OPEnSLab-OSU/OPEnSampler/README.md

# OPEnSampler
Code and materials for OPEnSampler: an Open-Source, inexpensive peristaltic pump-driven, air-tight, sampler device.
