OPEnSLab-OSU/OPEnSampler/2017 Q4/Code/FlowCharts/ReadMe

Flowchart "state machine" diagrams of code go here
