OPEnSLab-OSU/OPEnSampler/capstone/BOM/ReadMe

Place Ongoing Bill of Materials List and Links here
