OPEnSLab-OSU/OPEnSampler/2017 Q4/OPEnSampler Bag Bill of Materials v1.xlsx

Sheet: Electronics
Type | Value, Part # | Footprint Info | Quantity | PCB ID | Source | Cost/Unit | Cost
Capacitor | 100 uF | Electrolytic (2.54mm Pitch) | 2 | C1, C2 |  |  | 0
Capacitor | 10 nF | Ceramic (2.54mm pitch) | 2 | C3, C4 |  |  | 0
Capacitor | 10 uF | Electrolytic (2.54mm Pitch) | 2 | C5, C10 |  |  | 0
Capacitor | 0.1 uF | Ceramic (2.54mm pitch) | 5 | C6, C7, C8, C9, C11 |  |  | 0
Resistor | 1k | 0207/7 1/4 Watt | 1 | R1 |  |  | 0
Resistor | 10k | 0207/7 1/4 Watt | 1 | R2 |  |  | 0
Resistor | 30k | 0207/7 1/4 Watt | 1 | R3 |  |  | 0
Inductor | 2.2uH | 0309/10, 2.6A | 1 | L1 | Digikey (https://www.digikey.com/product-detail/en/abracon-llc/AIAP-01-2R2K-T/AIAP-01-2R2K-TCT-ND/3060625) | 0.38 | 0.38
Female Header | 1x8 | 2.54mm Squarepin | 1 | RTC |  |  | 0
Male JST Socket | 1x2 | 2.54mm Squarepin | 10 | ENABLE_INT, FLUSH, JP4, MO-JST, RTC_INT, Buttons 1-4, A-E | Digikey (https://www.digikey.com/product-detail/en/B2B-XH-A(LF)(SN)/455-2247-ND/1651045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) | 0.15 | 1.5
Male Header | 2x3 | 2.54mm Squarepin | 3 | 5V_BREAKOUT, I2C_BREAKOUT, RTC_INT_BREAKOUT |  |  | 0
Male Header | 1x3 | 2.54mm Squarepin | 1 | FLOW_METER |  |  | 0
Male Header | 1x9 | 2.54mm Squarepin | 1 | GSM |  |  | 0
Male Header | 1x6 | 2.54mm Squarepin | 1 | OLED |  |  | 0
Screw Terminal | 1x2 | 3.5mm Pitch, 1.2mm RoundPin | 2 | J1, MO_SCEW | Adafruit (https://www.adafruit.com/product/724) | 0.59 | 1.18
Rectangular Socket | 2x7 | 2.54mm pitch and spacing | 2 | VBB1, VBB2 | Digikey (https://www.digikey.com/product-detail/en/3m/N2514-6002-RB/MHC14K-ND/755177) | 1.89 | 3.78
IC Socket |  | DIL20 | 4 | IC1, IC2, IC3, IC4 | Digikey (https://www.digikey.com/product-detail/en/assmann-wsw-components/A-20-LC-TT/AE9998-ND/821752) | 0.29 | 1.16
 |  |  |  |  |  |  | 0
Shift Register | TPIC6B596 |  | 4 | IC1, IC2, IC3, IC4 | Digikey (https://www.digikey.com/product-detail/en/texas-instruments/TPIC6B596N/296-34573-5-ND/1670631) | 1.67 | 6.68
Arduino | Uno R3 |  | 1 | U1 | Arduino.cc |  | 0
GSM | FONA 808 2G |  | 1 | GSM | Adafruit (https://www.adafruit.com/product/2542) |  | 0
RTC | DS3231 |  | 1 | RTC | adafruit (https://www.adafruit.com/product/3013) | 13.95 | 13.95
OLED | SSD1306 |  | 1 | OLED | adafruit (https://www.adafruit.com/product/931) | 17.5 | 17.5
H Bridge | DRV8871 |  | 1 | U$1 | digikey (https://www.digikey.com/product-detail/en/texas-instruments/DRV8871DDAR/296-43024-1-ND/5722182) | 2.44 | 2.44
Flow Meter |  |  | 1 | FLOW_METER | adafruit (https://www.adafruit.com/product/828) | 9.95 | 9.95
Toggle Switch |  |  | 2 | JP4, ENABLE_INT | amazon (https://www.amazon.com/FBApayipa-Solder-Rocker-Switch-Toggle/dp/B01N2U8PK0) | 0.466 | 0.932
Interrupt Button |  |  | 1 | RTC_INT | Amazon (https://www.amazon.com/gp/product/B01IU898QA) | 0.699 | 0.699
Female Barrel Jack |  |  | 1 | Power Supply | Adafruit (https://www.adafruit.com/product/610) | 2.95 | 2.95
Female JST Housing | 1x2 (2.5mm) |  | 4 | ENABLE_INT, Power Supply, MO-JST, RTC_INT | Digikey (https://www.digikey.com/product-detail/en/jst-sales-america-inc/XHP-2/455-2266-ND/555485) | 0.1 | 0.4
JST XH Crimp Terminal | SxH-001T-P.6 |  | 8 | ENABLE_INT, Power Supply, MO-JST, RTC_INT | Digikey (https://www.digikey.com/product-detail/en/jst-sales-america-inc/SXH-001T-P0.6/455-1135-1-ND/527370) | 0.1 | 0.8
Rectangular Cable ASM. | M3DDA-1406J | 2.54mm pitch and spacing, Female, .5' | 2 | VBB1, VBB2 | Digikey (https://www.digikey.com/product-detail/en/3m/M3DDA-1406J/M3DDA-1406J-ND/230202) | 2.81 | 5.62
Battery | 2000 mAh |  | 1 | Power Supply | Amazon (https://www.amazon.com/Tenergy-2000mAh-Battery-Leads-Airplanes/dp/B00408X4LU) | 23.92 | 23.92
Stacking Headers |  | 2.54mm pitch, Squarepin Long Centered | 1 | Arduino Interfacing | Sparkfun (https://www.sparkfun.com/products/12693)
 |  |  |  |  |  |  | 93.841

Sheet: New Hydraulics
Item | Type and Dimensions | Source | QTY Per Order | Pieces Needed | Unit Price | Sampler Cost | Order | Description
PP Tube Fitting | 1/4'' OD x 1/8 MPT | usplastics (https://www.usplastic.com/catalog/item.aspx?itemid=29104&catid=603) | 1 | 24 | 0.63 | 15.12 | 24 | Bag Fittings
PP Tube Fitting | 1/4'' OD Tee | usplastics (https://www.usplastic.com/catalog/item.aspx?itemid=29008&catid=603) | 1 | 24 | 1.62 | 38.88 | 24 | Valve Tees
Spout Pack Bag | 250mL | IMPAK (http://www.impakcorporation.com/flexible_packaging/FTSSP250CSISL) | 500 | 24 | 0.33 | 7.92 | 1 | Sample Bags
Solenoid Valve | 2-POS Momentary NC | Shenzhen (https://pumpdyx.en.alibaba.com/product/1611593518-214713352/miniature_water_dispenser_solenoid_valve_DC6V_12V.html) | 100 | 26 | 1 | 26 | 1 | Valve
Peristaltic Pump | 202.330.012.050 | WMC Pumps (http://www.wmcpumps.com/index.php/series-200) | 1 | 1 | 60 | 60 | 1 | Pump
Push to Connect Bulkhead | 1/4''OD x 1/4'' OD x .67'' hole | usplastics (https://www.usplastic.com/catalog/item.aspx?itemid=42963&catid=833) | 1 | 2 | 3.34 | 6.68 | 2
Brass Straight Adapter | 1/2'' FNPT x 1/4'' tube OD | mcmaster (https://www.mcmaster.com/) | 1 | 2 | 7.97 | 15.94 | 2 | Flow Meter Adapter 1
PVDF Tubing | .17'' ID x .25'' OD | usplastics (https://www.usplastic.com/catalog/item.aspx?itemid=32842&catid=840) | 50 | 1 | 54.5 | 54.5 | 1 | Teflon Tubing
Mesh Filter | 480 micron, open ends | grainger (https://www.grainger.com/product/GRAINGER-APPROVED-3-3-4-Polypropylene-Filter-6UJJ7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) | 1 | 1 | 8.61 | 8.61 | 1 | Inlet Filter
O-Ring | 15mmID x 2mm CS | McMaster (https://www.mcmaster.com/) | 25 | 24 | 0.2452 | 5.8848 | 1 | Bag Cap Sealing
 |  |  |  |  |  | 239.5348

Sheet: Frame
Item | Type | Dimensions | Source | Quantity | Unit Cost | Cost | Comments
Machine Screw | M3 | 8mm | McMaster (https://www.mcmaster.com/) | 1 | 6 | 6
Machine Screw | M3 | 6mm x .5mm | McMaster (https://www.mcmaster.com/) | 1 | 6 | 6
Nut | M3 | M3 x .5mm | McMaster (https://www.mcmaster.com/) | 1 | 2 | 2
Machine Screw | M2 | 10mm x .4mm | Mcmaster (https://www.mcmaster.com/) | 1 | 6 | 6
Nut | M2 | M2 x .4mm | McMaster (https://www.mcmaster.com/) | 1 | 2 | 2
Aluminum Extrusion | HFS3-1515 | 610mm | Misumi (https://us.misumi-ec.com/vona2/detail/110300465870/?Inch=0&CategorySpec=00000042747%3A%3A15) | 5 | 3 | 15
Aluminum Extrusion | HFS3-1515 | 310mm | Misumi (https://us.misumi-ec.com/vona2/detail/110300465870/?Inch=0&CategorySpec=00000042747%3A%3A15) | 4 | 2.64 | 10.56
Aluminum Extrusion | HFS3-1515 | 200mm | Misumi (https://us.misumi-ec.com/vona2/detail/110300465870/?Inch=0&CategorySpec=00000042747%3A%3A15) | 6 | 2.64 | 15.84
Extrusion Bracket | HBLTBS3 |  | Misumi (https://us.misumi-ec.com/vona2/detail/110302755570/?Inch=0) | 32 | 0.75 | 24
T-Nut | HNSQ3-3 |  | Misumi (https://us.misumi-ec.com/vona2/detail/110300465710/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) | 1 | 8.28 | 8.28
Zipties | .1 in | .1'' x 4'' | Amazon (https://www.amazon.com/dp/B01018DB2E?ref=emc_b_5_t) |  | 4.99 |  | cable management and attaching valves
 |  |  |  |  |  | 95.68
