OPEnSLab-OSU/OPEnSampler/2017 Q4/Printed Components/Battery Case 9 - Case.stl

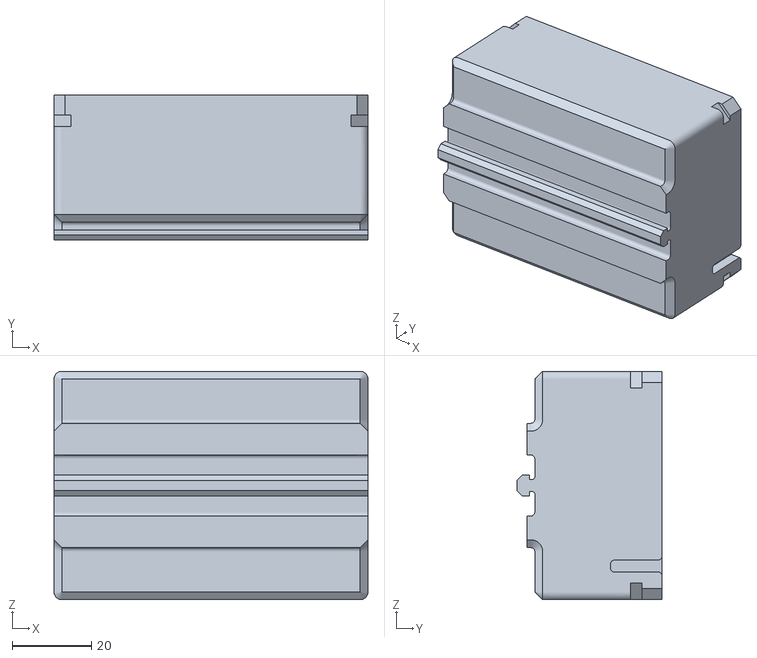
[picture p1: CAD file, 2017-11-14]
2017 Q4/Printed Components/Battery Case 9 - Case.stl
79.2 x 36.6 x 57.7
