OPEnSLab-OSU/OPEnSampler/capstone/15mm Extrusion Base/3D Printed Parts/STLs/Battery Holder Bottom July 13.stl

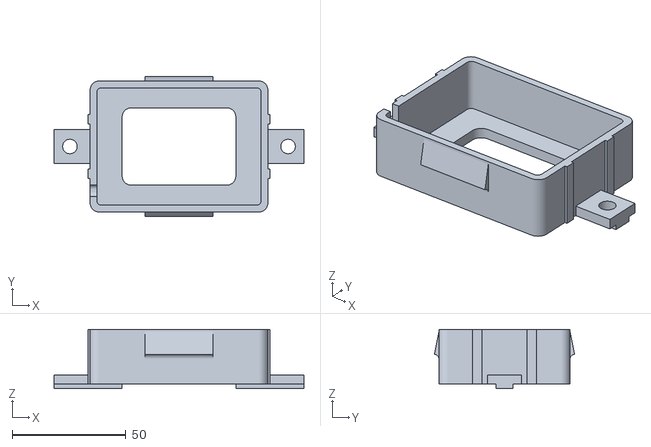
[picture p2: CAD file, 2017-07-13]
capstone/15mm Extrusion Base/3D Printed Parts/STLs/Battery Holder Bottom July 13.stl
110.0 x 61.7 x 26.0
