OPEnSLab-OSU/OPEnSampler/capstone/15mm Extrusion Base/Laser Cut Parts/DXF Files/Top Panel July 13.dxf

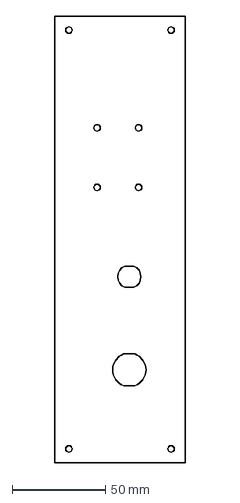
[picture p3: CAD file, 2017-07-13]
capstone/15mm Extrusion Base/Laser Cut Parts/DXF Files/Top Panel July 13.dxf
70.0 x 240.0 mm
