OPEnSLab-OSU/OPEnSampler/capstone/Water Sampler Prints/T_bracket_4040-3030.stl

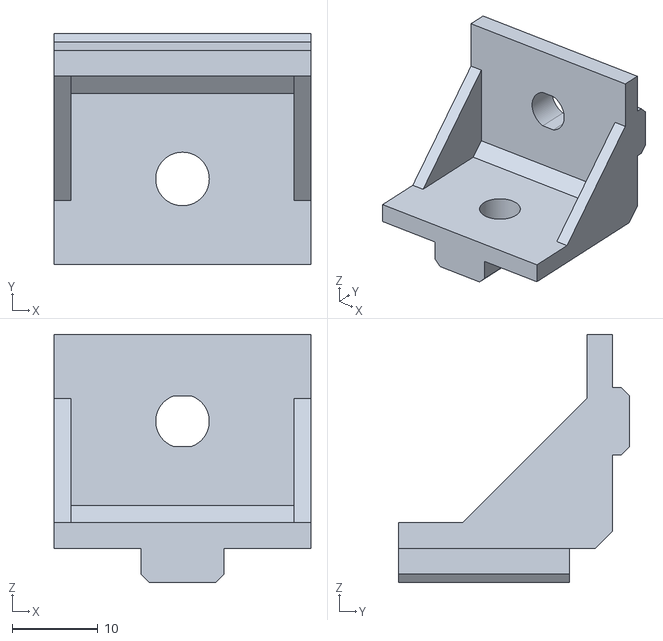
[picture p4: CAD file, 2017-11-07]
capstone/Water Sampler Prints/T_bracket_4040-3030.stl
30.0 x 27.0 x 29.0
