OPEnSLab-OSU/OPEnSampler/2017 Q4/Printed Components/VBB Case 9 - Cap.stl

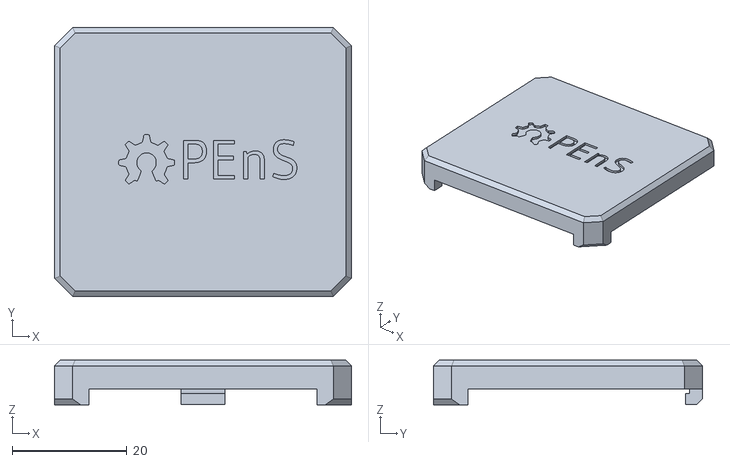
[picture p5: CAD file, 2017-11-14]
2017 Q4/Printed Components/VBB Case 9 - Cap.stl
51.8 x 47.0 x 7.80
