OPEnSLab-OSU/OPEnSampler/capstone/15mm Extrusion Base/3D Printed Parts/STLs/Valve Mount July 13.stl

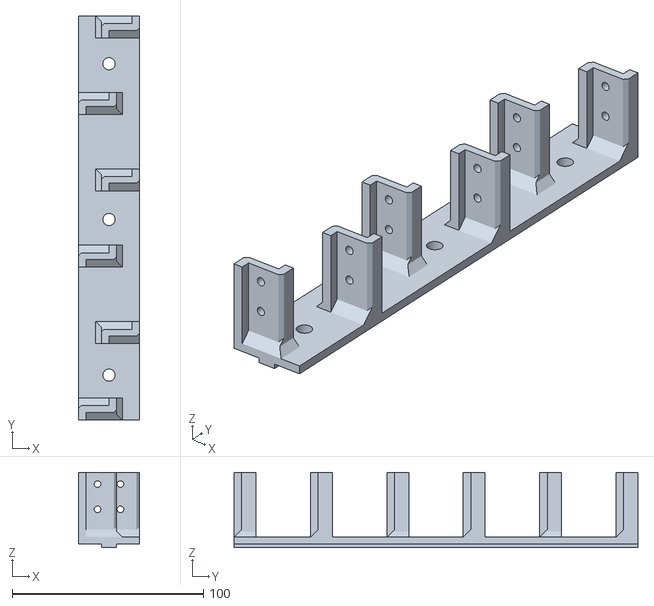
[picture p6: CAD file, 2017-07-13]
capstone/15mm Extrusion Base/3D Printed Parts/STLs/Valve Mount July 13.stl
32.0 x 211.5 x 39.5
