OPEnSLab-OSU/OPEnSampler/capstone/Water Sampler Prints/board_mount.stl

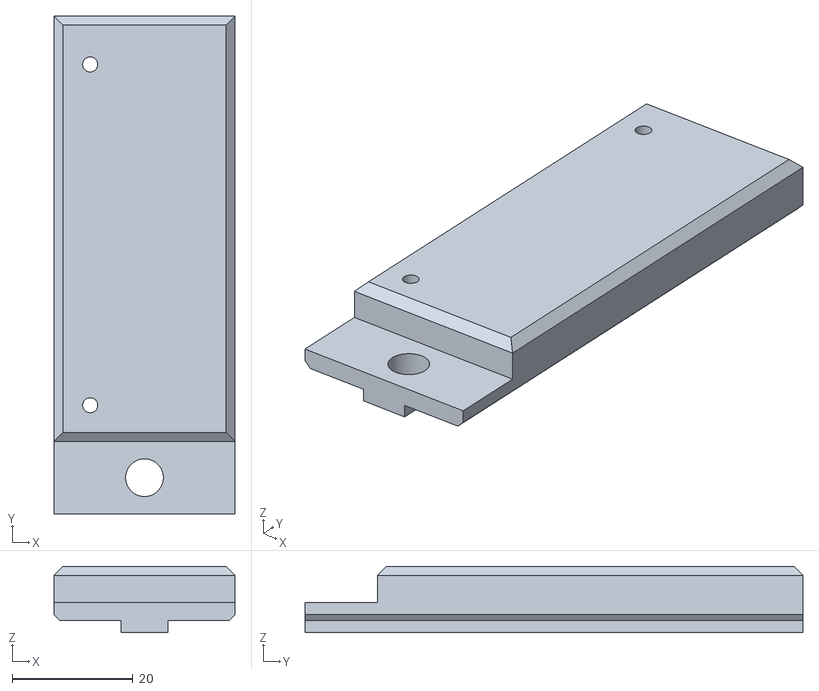
[picture p7: CAD file, 2017-11-07]
capstone/Water Sampler Prints/board_mount.stl
30.0 x 82.5 x 11.0
