OPEnSLab-OSU/OPEnSampler/2017 Q4/Printed Components/MCB Case 14 - Cap.stl

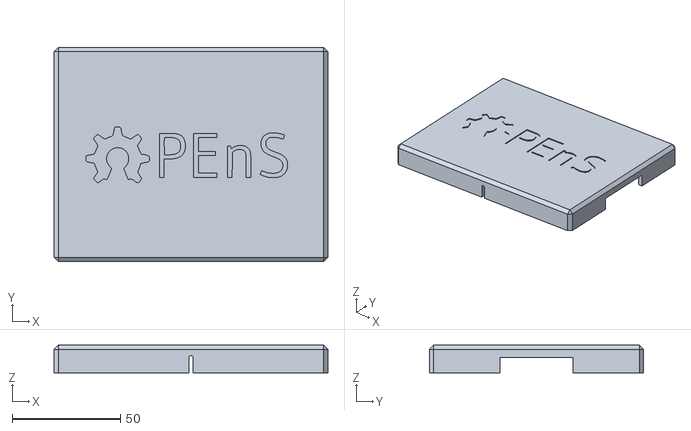
[picture p8: CAD file, 2017-11-14]
2017 Q4/Printed Components/MCB Case 14 - Cap.stl
126.8 x 99.2 x 12.9
