OPEnSLab-OSU/OPEnSampler/capstone/15mm Extrusion Base/3D Printed Parts/STLs/Bag Cap Inner July 13.stl

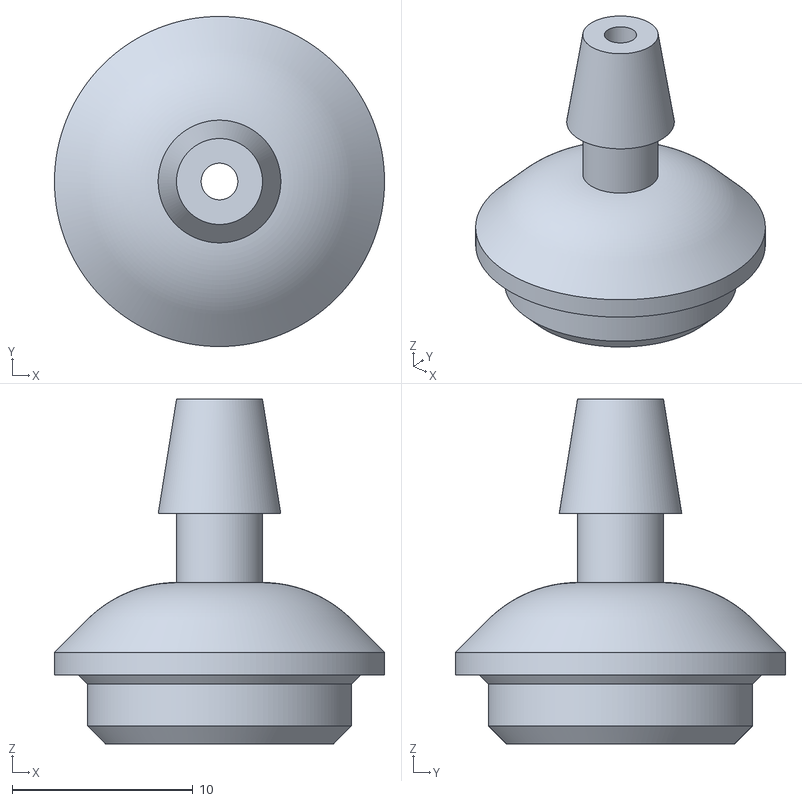
[picture p9: CAD file, 2017-07-13]
capstone/15mm Extrusion Base/3D Printed Parts/STLs/Bag Cap Inner July 13.stl
18.3 x 18.3 x 19.1
