OPEnSLab-OSU/OPEnSampler/capstone/Water Sampler Prints/arduino_mount.stl

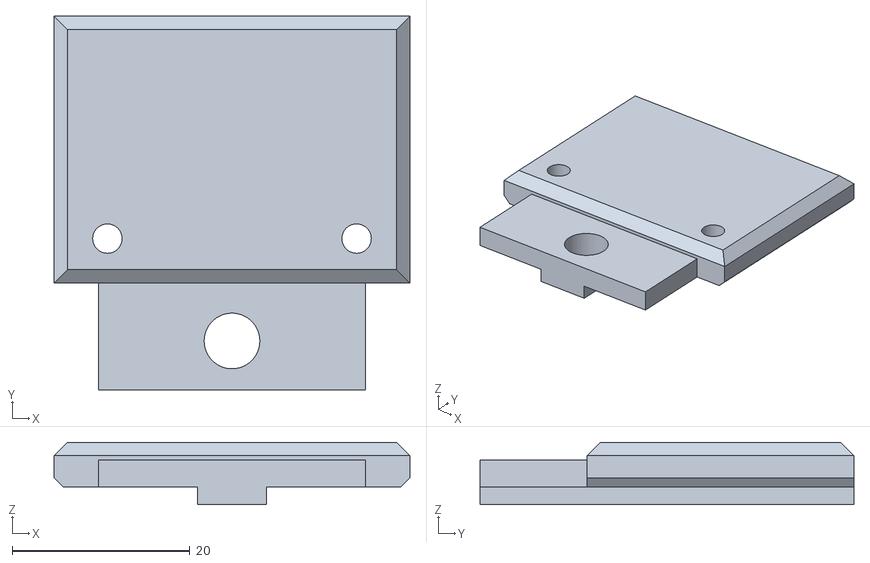
[picture p10: CAD file, 2017-11-07]
capstone/Water Sampler Prints/arduino_mount.stl
40.0 x 42.0 x 7.00
