OPEnSLab-OSU/OPEnSampler/2017 Q4/Printed Components/MCB Case 14 - Case.stl

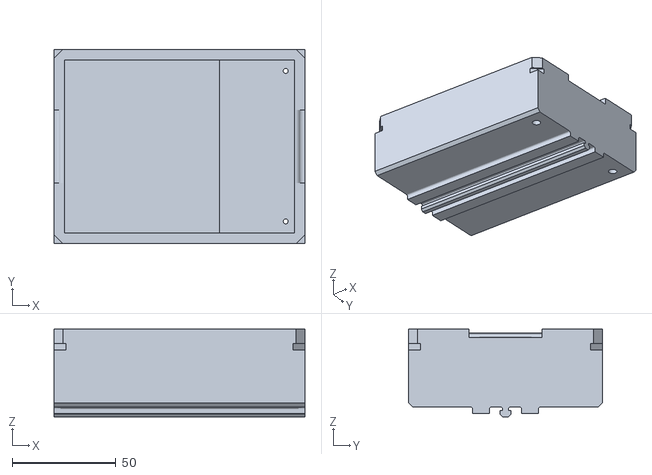
[picture p11: CAD file, 2017-11-14]
2017 Q4/Printed Components/MCB Case 14 - Case.stl
120.8 x 93.2 x 42.3
