OPEnSLab-OSU/OPEnSampler/capstone/15mm Extrusion Base/3D Printed Parts/STLs/Pump Mount July 13.stl

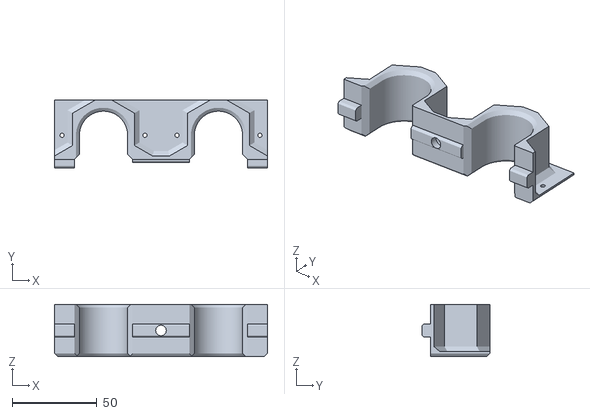
[picture p12: CAD file, 2017-07-13]
capstone/15mm Extrusion Base/3D Printed Parts/STLs/Pump Mount July 13.stl
126.0 x 40.0 x 31.0
