OPEnSLab-OSU/OPEnSampler/capstone/Water Sampler Prints/tnut_3030_v2.stl

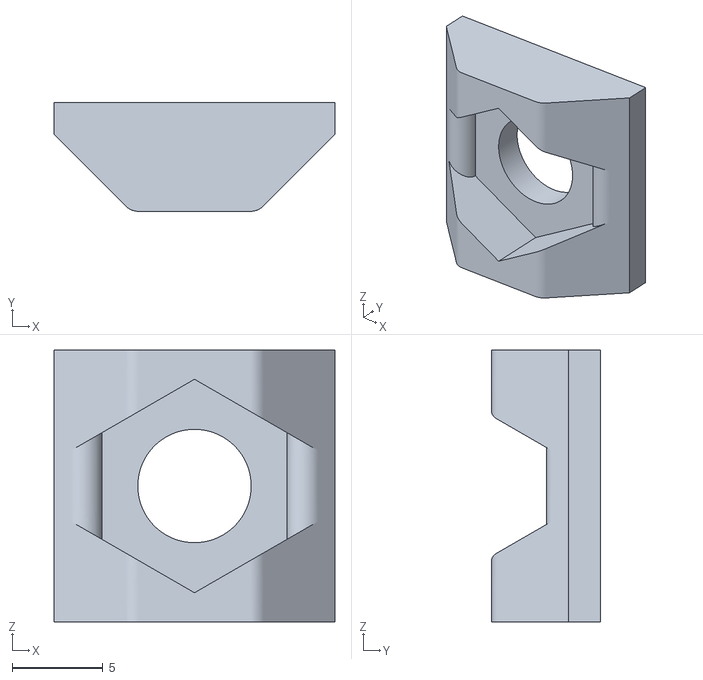
[picture p13: CAD file, 2017-11-07]
capstone/Water Sampler Prints/tnut_3030_v2.stl
15.5 x 6.00 x 15.0
