OPEnSLab-OSU/OPEnSampler/2017 Q4/Printed Components/VBB Case 9 - Case.stl

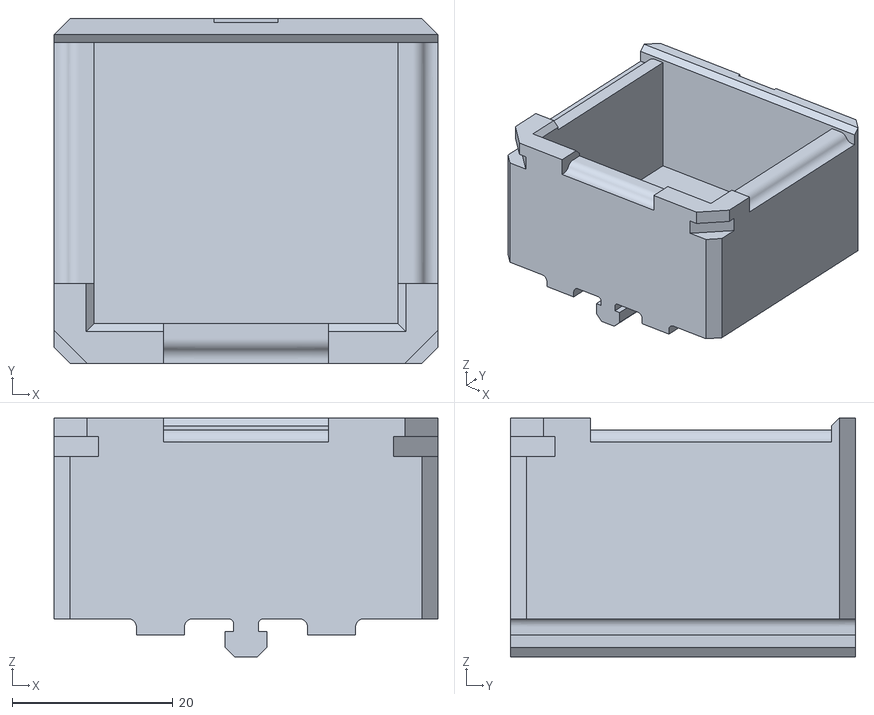
[picture p14: CAD file, 2017-11-14]
2017 Q4/Printed Components/VBB Case 9 - Case.stl
47.8 x 43.0 x 29.8
