OPEnSLab-OSU/OPEnSampler/capstone/15mm Extrusion Base/3D Printed Parts/STLs/spine spacer july 13.stl

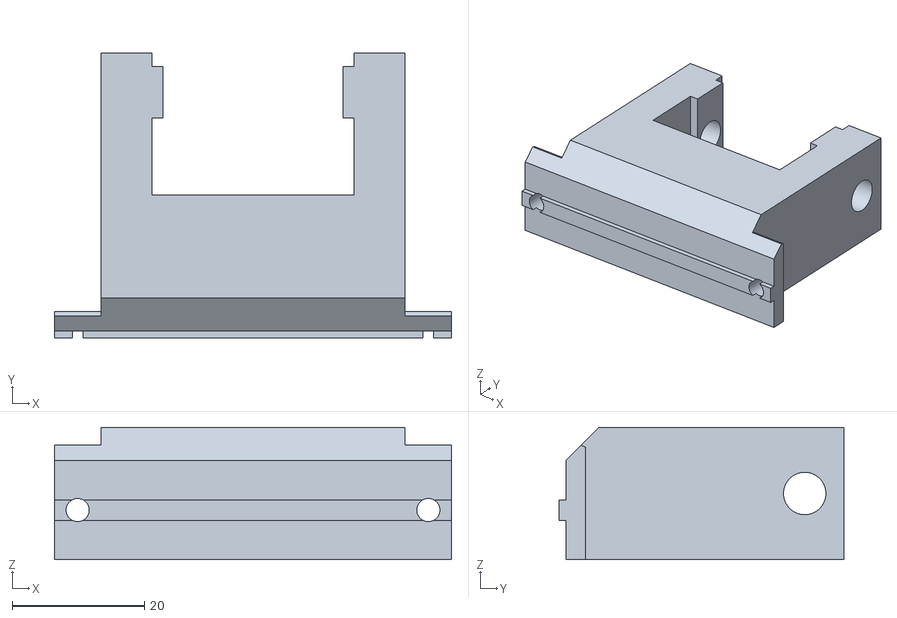
[picture p15: CAD file, 2017-07-13]
capstone/15mm Extrusion Base/3D Printed Parts/STLs/spine spacer july 13.stl
60.0 x 43.0 x 20.0
