OPEnSLab-OSU/OPEnSampler/capstone/Water Sampler Prints/valve_mount_U3030 v9.stl

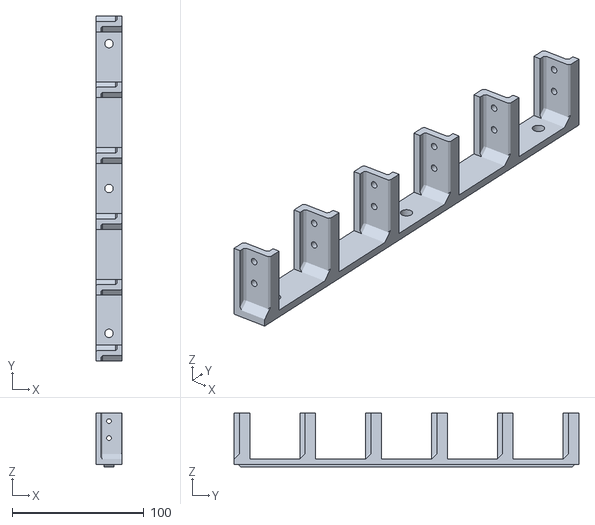
[picture p16: CAD file, 2017-11-07]
capstone/Water Sampler Prints/valve_mount_U3030 v9.stl
20.0 x 262.0 x 41.0
