OPEnSLab-OSU/OPEnSampler/2017 Q4/Printed Components/Battery Case 9 - Cap.stl

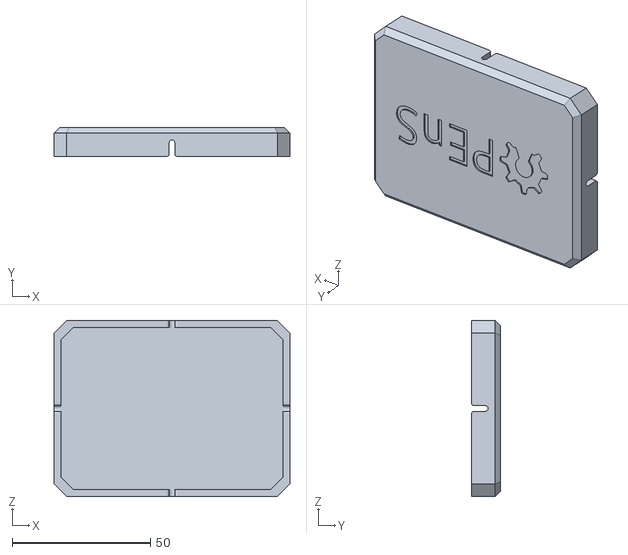
[picture p17: CAD file, 2017-11-14]
2017 Q4/Printed Components/Battery Case 9 - Cap.stl
85.2 x 10.5 x 63.7
