OPEnSLab-OSU/OPEnSampler/capstone/15mm Extrusion Base/3D Printed Parts/STLs/Bag Cap Outer July 13.stl

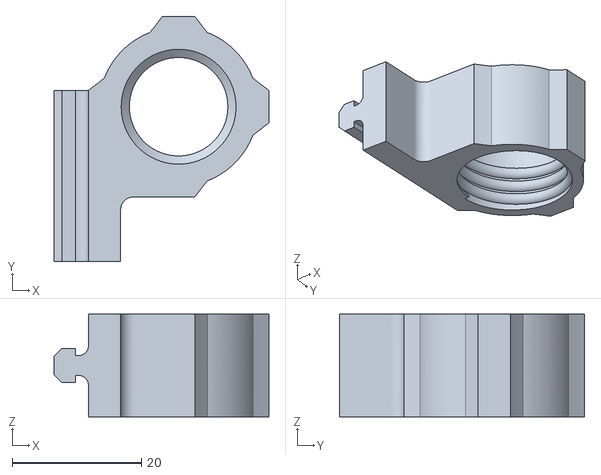
[picture p18: CAD file, 2017-07-13]
capstone/15mm Extrusion Base/3D Printed Parts/STLs/Bag Cap Outer July 13.stl
33.2 x 37.9 x 15.9
