OPEnSLab-OSU/OPEnSampler/2017 Q4/Printed Components/Bag Cap 10.stl

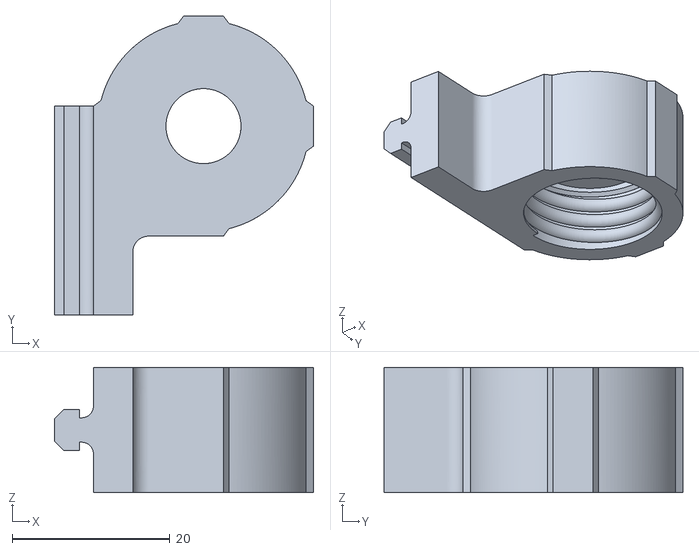
[picture p19: CAD file, 2017-11-14]
2017 Q4/Printed Components/Bag Cap 10.stl
32.9 x 37.9 x 15.9
