OPEnSLab-OSU/OPEnSampler/capstone/15mm Extrusion Base/3D Printed Parts/STLs/Battery Holder Top July 13.stl

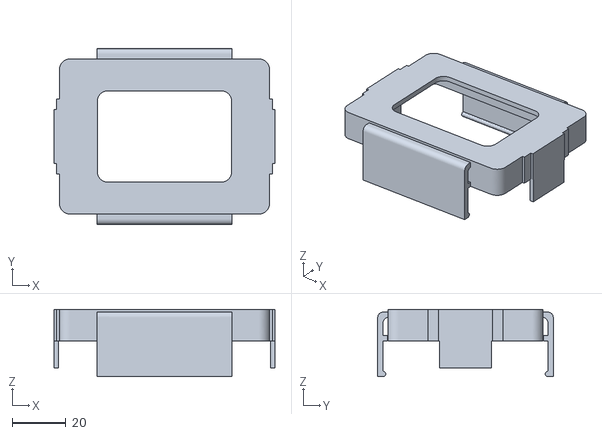
[picture p20: CAD file, 2017-07-13]
capstone/15mm Extrusion Base/3D Printed Parts/STLs/Battery Holder Top July 13.stl
82.2 x 65.3 x 25.0
