OPEnSLab-OSU/OPEnSampler/2017 Q4/Printed Components/Flow Meter Mount 7.stl

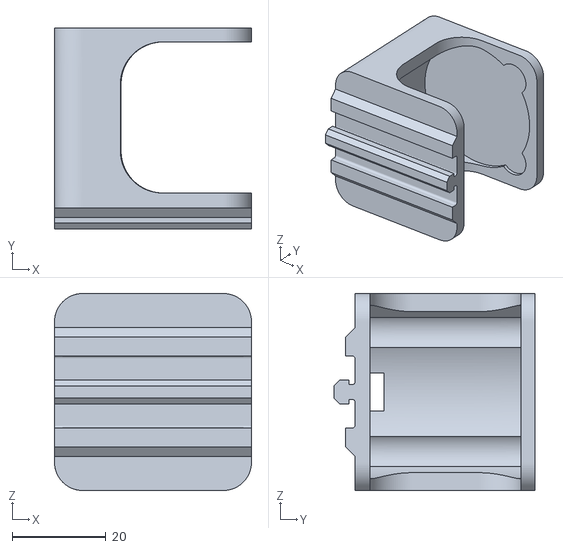
[picture p21: CAD file, 2017-11-14]
2017 Q4/Printed Components/Flow Meter Mount 7.stl
42.0 x 42.9 x 42.0
