OPEnSLab-OSU/OPEnSampler/2017 Q4/Printed Components/Valve Slider 1.stl

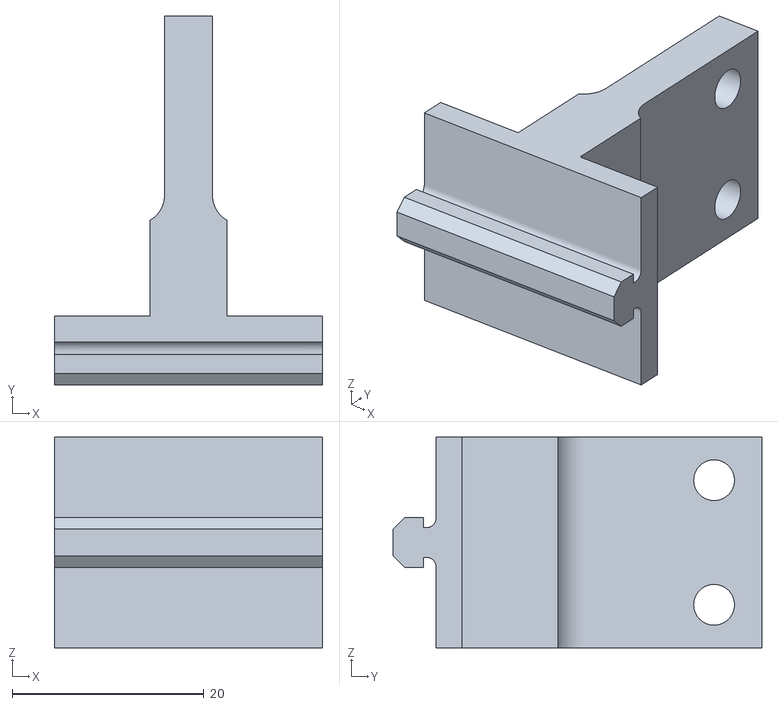
[picture p22: CAD file, 2017-11-14]
2017 Q4/Printed Components/Valve Slider 1.stl
28.0 x 38.5 x 22.0
