OPEnSLab-OSU/OPEnSampler/(list of files, cad)

Other CAD files:
capstone/15mm Extrusion Base/3D Printed Parts/Fusion360 Part Files/Bag Cap July 13.f3d
capstone/15mm Extrusion Base/3D Printed Parts/Fusion360 Part Files/Battery Holder July 13.f3d
capstone/15mm Extrusion Base/3D Printed Parts/Fusion360 Part Files/Pump Mount July 13.f3d
capstone/15mm Extrusion Base/3D Printed Parts/Fusion360 Part Files/Spine Spacer July 13.f3d
capstone/15mm Extrusion Base/3D Printed Parts/Fusion360 Part Files/Valve Mount July 13.f3d
capstone/15mm Extrusion Base/3D Printed Parts/Fusion360 Part Files/vSlot Bolt Head 30mm M6 July 13.f3d
capstone/15mm Extrusion Base/Laser Cut Parts/Part Files/Top Panel July 13.f3d
