OPEnSLab-OSU/OPEnSampler/2017 Q4/CAD/Assembly Link.txt

The assembly can be viewed and downloaded at the following link:

http://a360.co/2iAnQlj
