OPEnSLab-OSU/OPEnSampler/(threads)

Thread 11 (2020-06-24):

Battery voltage reduce over time

nguyenb5, 2020-06-24:
The current system doesn't have flow-meter so the whole system is time based. When the battery voltage change, the flow-rate change and give us more than 10% variable.

If cap the system at 12V using buck converter, we can have consistent flow-rate.
