OPEnSLab-OSU/OPEnSampler/capstone/BOM/WS4040 v1 Bill of Materials.pdf

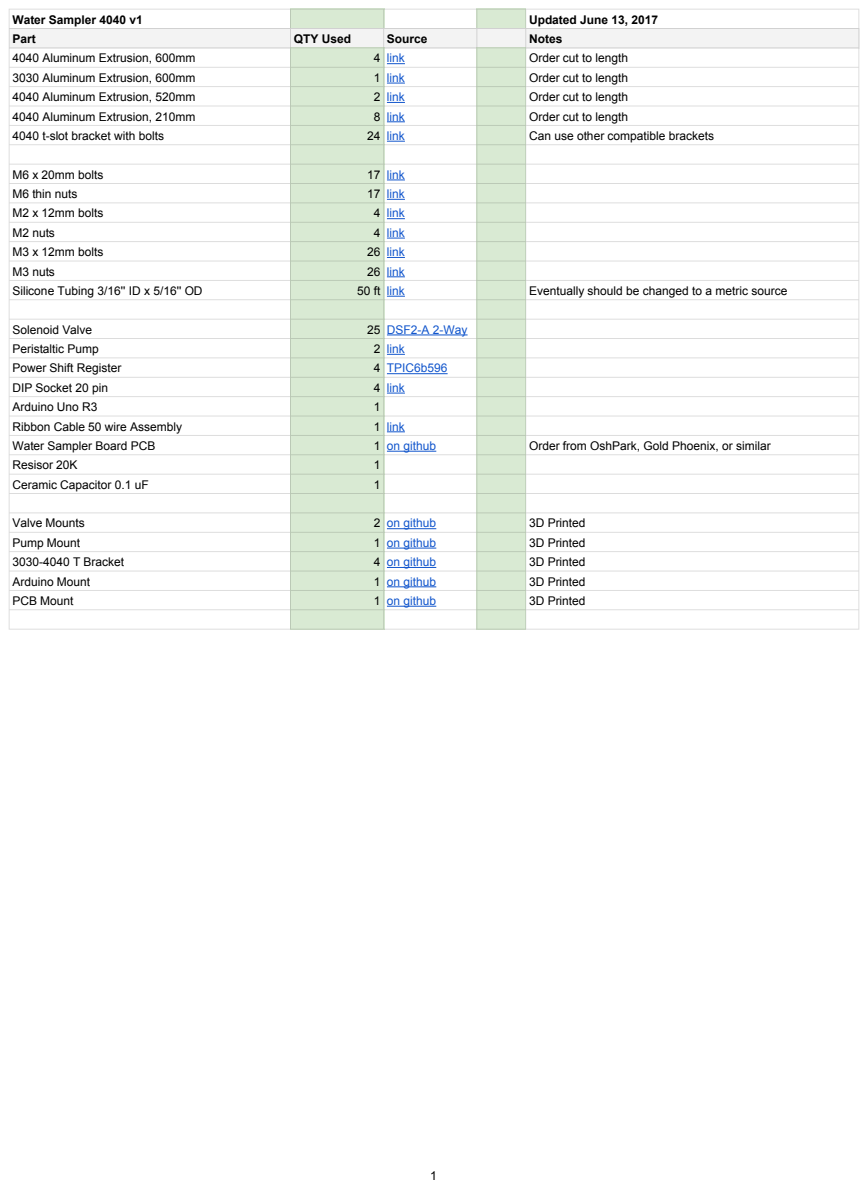
[picture p37: page 1]
Water Sampler 4040 v1; Updated June 13, 2017; Part; QTY Used; Source; Notes; 4040 Aluminum Extrusion, 600mm; link; Order cut to length; 3030 Aluminum Extrusion, 600mm; 4040 Aluminum Extrusion, 520mm; 4040 Aluminum Extrusion, 210mm; 4040 t-slot bracket with bolts; Can use other compatible brackets; M6 x 20mm bolts; M6 thin nuts; M2 x 12mm bolts; M2 nuts; M3 x 12mm bolts; M3 nuts; Silicone Tubing 3/16'' ID x 5/16'' OD; Eventually should be changed to a metric source; Solenoid Valve; DSF2-A 2-Way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
