OPEnSLab-OSU/OPEnSampler/2017 Q4/Code/FlowCharts/WaterSamplerSetup.pdf

# Setup

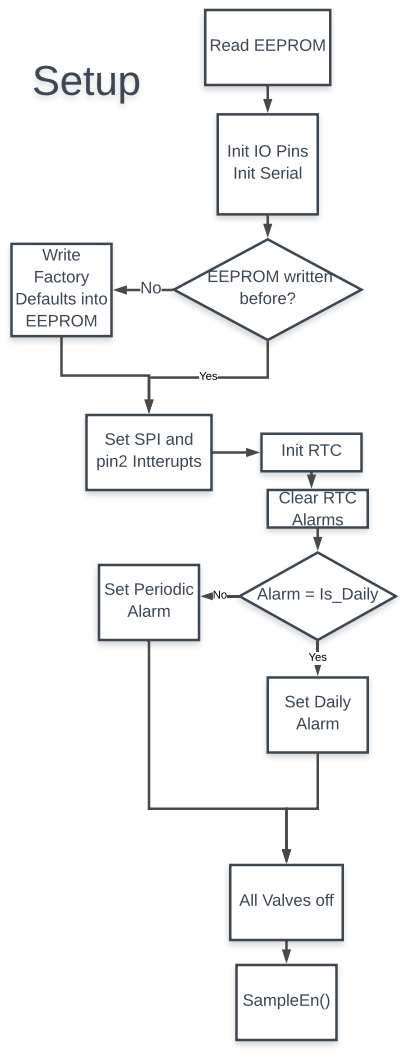
[picture p38: page 1]
Read EEPROM; EEPROM written before?; Write Factory Defaults into EEPROM; Alarm = Is_Daily; SampleEn(); Yes; Init RTC; Clear RTC Alarms; Set Daily Alarm; Set Periodic Alarm

Init IO Pins
Init Serial

Set SPI and
pin2 Intterupts

All Valves off

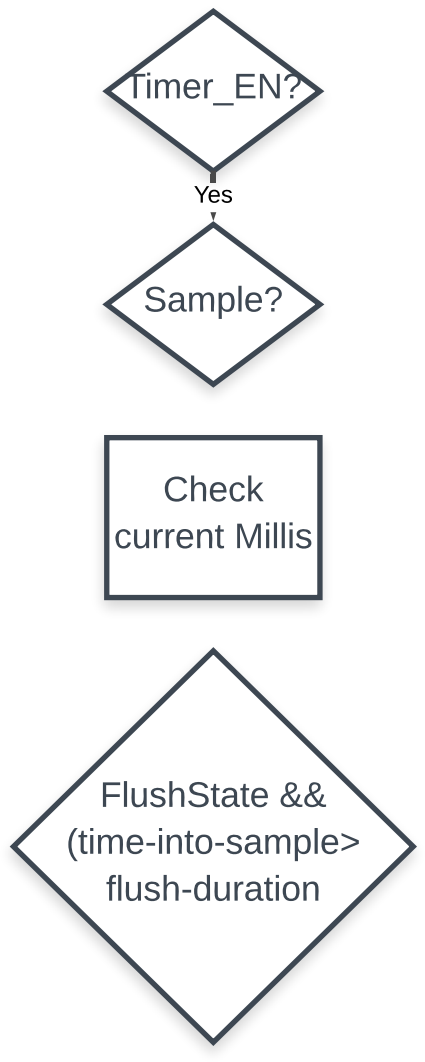
[picture p39: page 2]
Timer_EN?; Sample?; Yes; Check current Millis

FlushState &&
(time-into-sample>
flush-duration
