OPEnSLab-OSU/OPEnSampler/capstone/15mm Extrusion Base/Documents/Bill of Materials.pdf

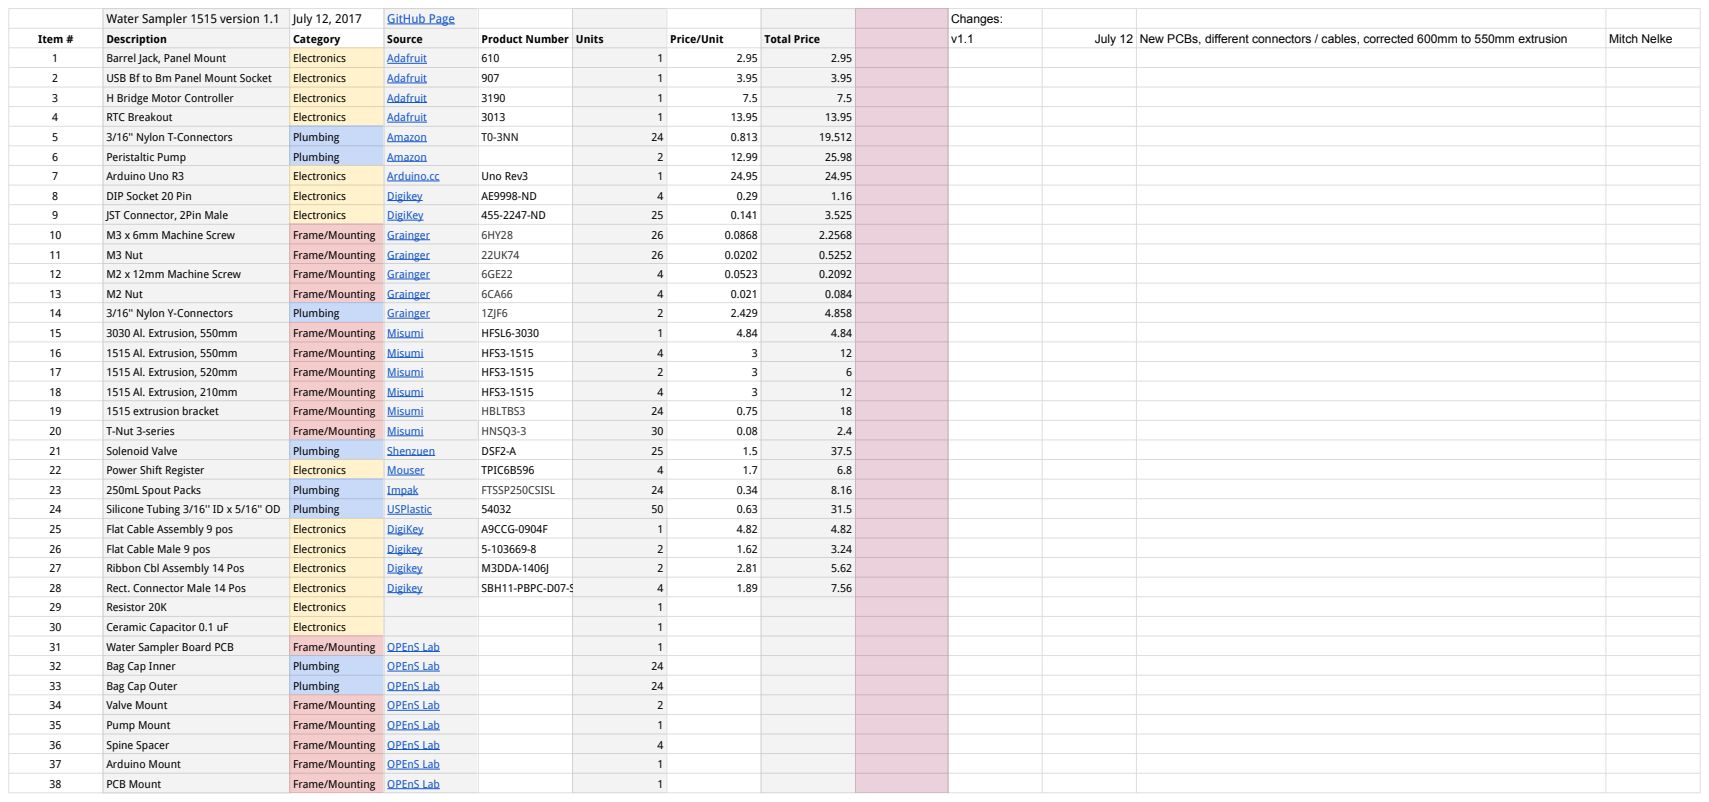
[picture p40: page 1]
Water Sampler 1515 version 1.1; July 12, 2017; GitHub Page; Changes:; Item #; Description; Category; Source; Product Number; Units; Price/Unit; Total Price; July 12 New PCBs, different connectors / cables, corrected 600mm to 550mm extrusion; Mitch Nelke; Barrel Jack, Panel Mount; Electronics; Adafruit; USB Bf to Bm Panel Mount Socket; H Bridge Motor Controller; RTC Breakout; 3/16'' Nylon T-Connectors; Plumbing; Amazon; Peristaltic Pump; Arduino Uno R3; Arduino.cc; Uno Rev3; DIP Socket 20 Pin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
