OPEnSLab-OSU/OPEnSampler/capstone/15mm Extrusion Base/3D Printed Parts/Drawings/1515 Assembly July 13.pdf

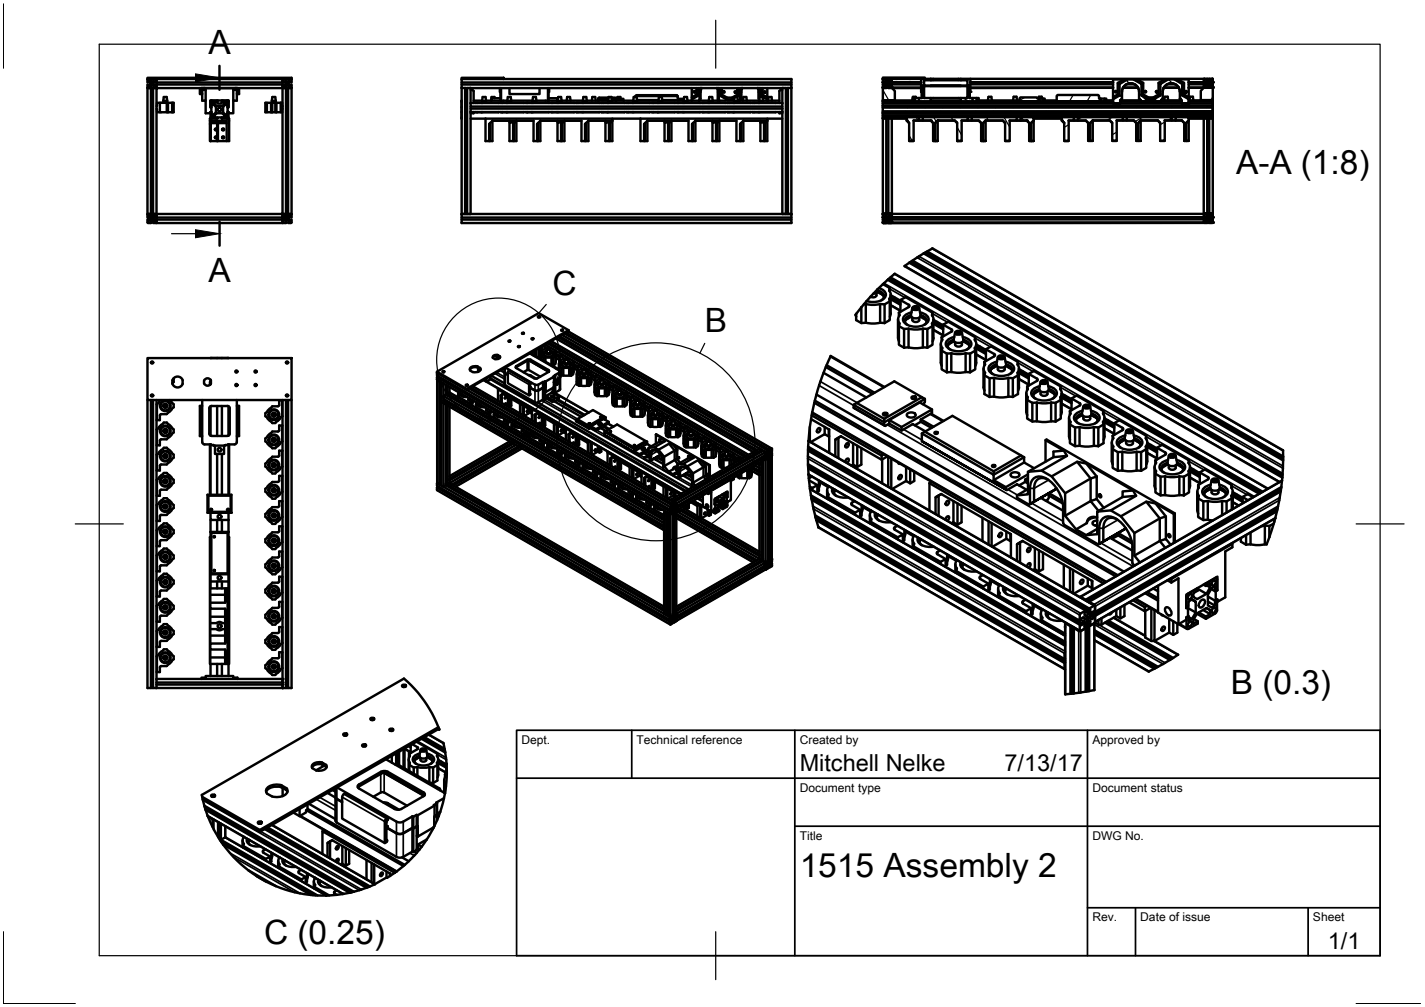
[picture p41: page 1]
Dept.; Technical reference; Created by; Approved by; Document type; Document status; Title; DWG No.; Rev.; Date of issue; Sheet; 1515 Assembly 2; Mitchell Nelke
