OPEnSLab-OSU/OPEnSampler/2017 Q4/Code/FlowCharts/OPEnSamlperLoop.pdf

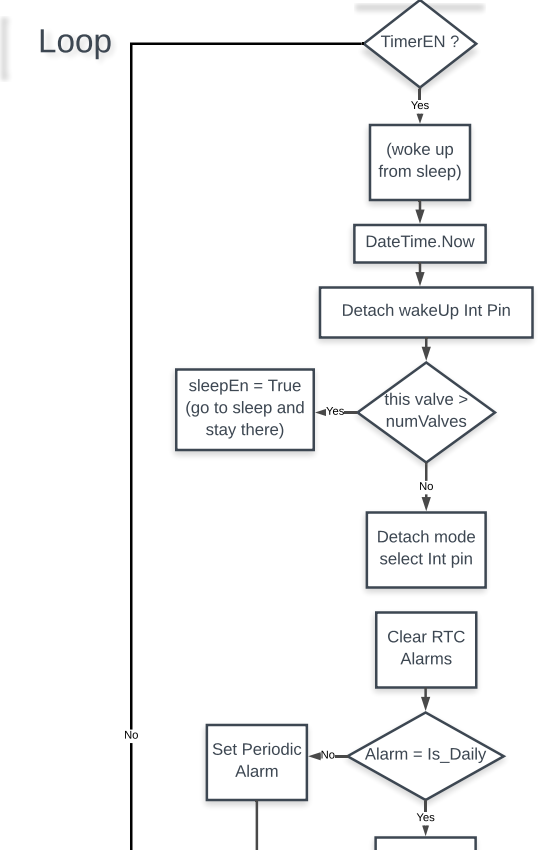
[picture p42: page 1]
(woke up from sleep); Loop; TimerEN ?; DateTime.Now; this valve > numValves; Yes; Clear RTC Alarms; Alarm = Is_Daily; Set Periodic Alarm

Detach wakeUp Int Pin

sleepEn = True
(go to sleep and
stay there)

Detach mode
select Int pin

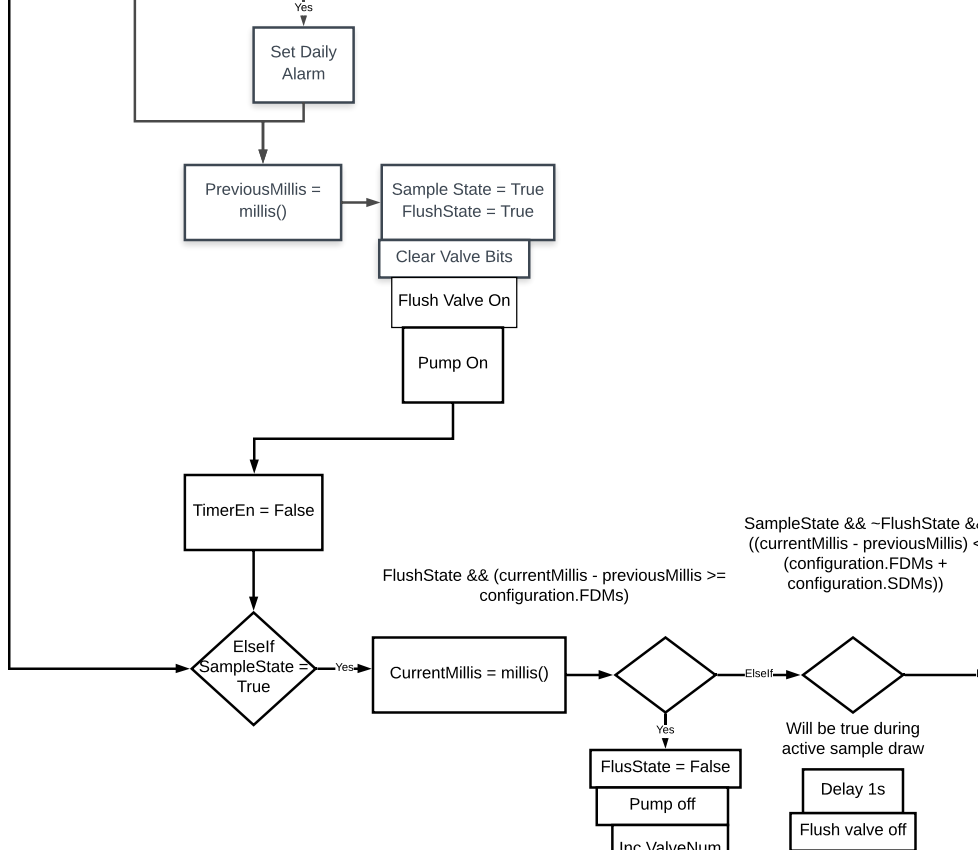
[picture p43: page 3]
Set Daily Alarm; Yes; PreviousMillis = millis(); Pump On; TimerEn = False; ElseIf SampleState = True; CurrentMillis = millis(); configuration.FDMs); FlusState = False; Pump off; Inc ValveNum; ElseIf; SampleState && ~FlushState && ((currentMillis - previousMillis) < (configuration.FDMs + configuration.SDMs)); Delay 1s

Sample State = True
FlushState = True

Clear Valve Bits

Flush Valve On

FlushState && (currentMillis - previousMillis >=

Will be true during
active sample draw

Flush valve off

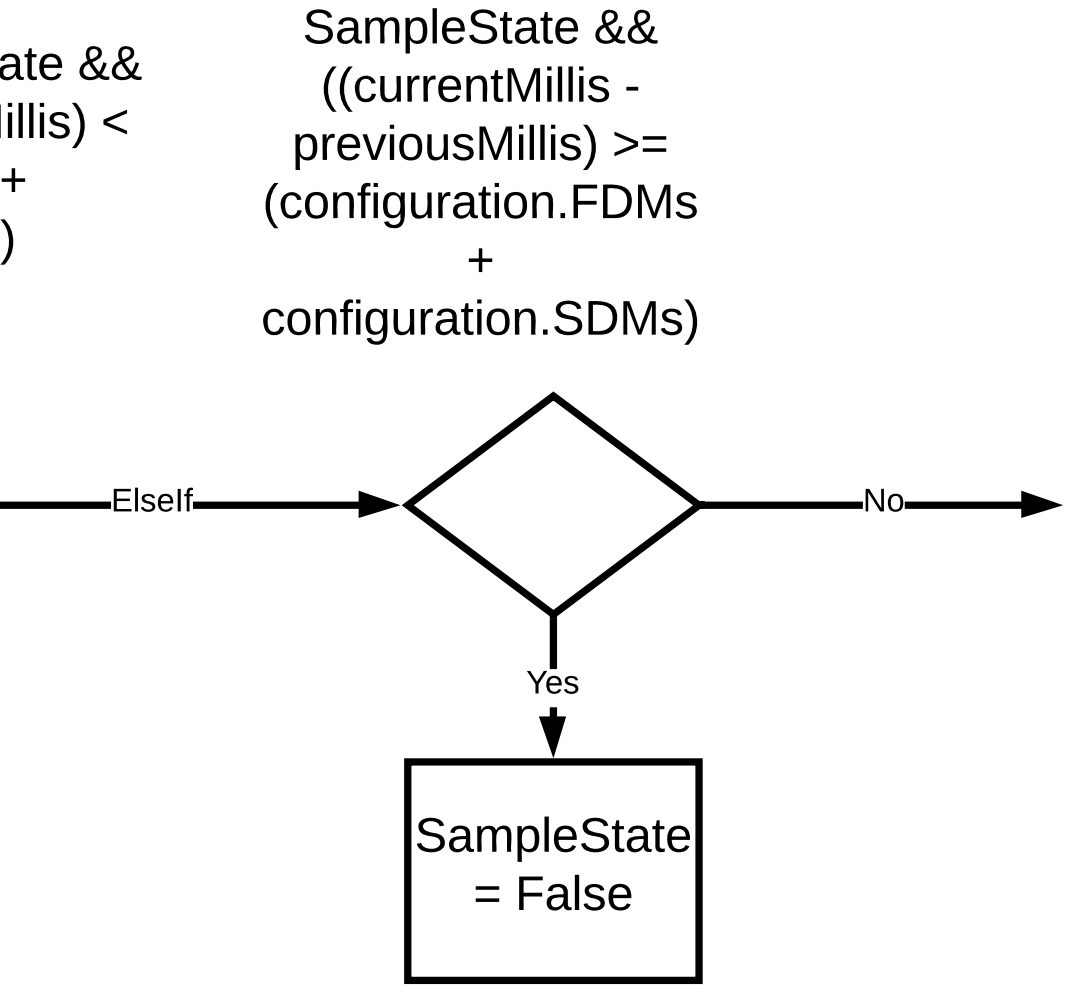
[picture p44: page 4]
SampleState && ~FlushState && ((currentMillis - previousMillis) < (configuration.FDMs + configuration.SDMs)); ElseIf; SampleState && ((currentMillis - previousMillis) >= (configuration.FDMs + configuration.SDMs); SampleState = False; Yes

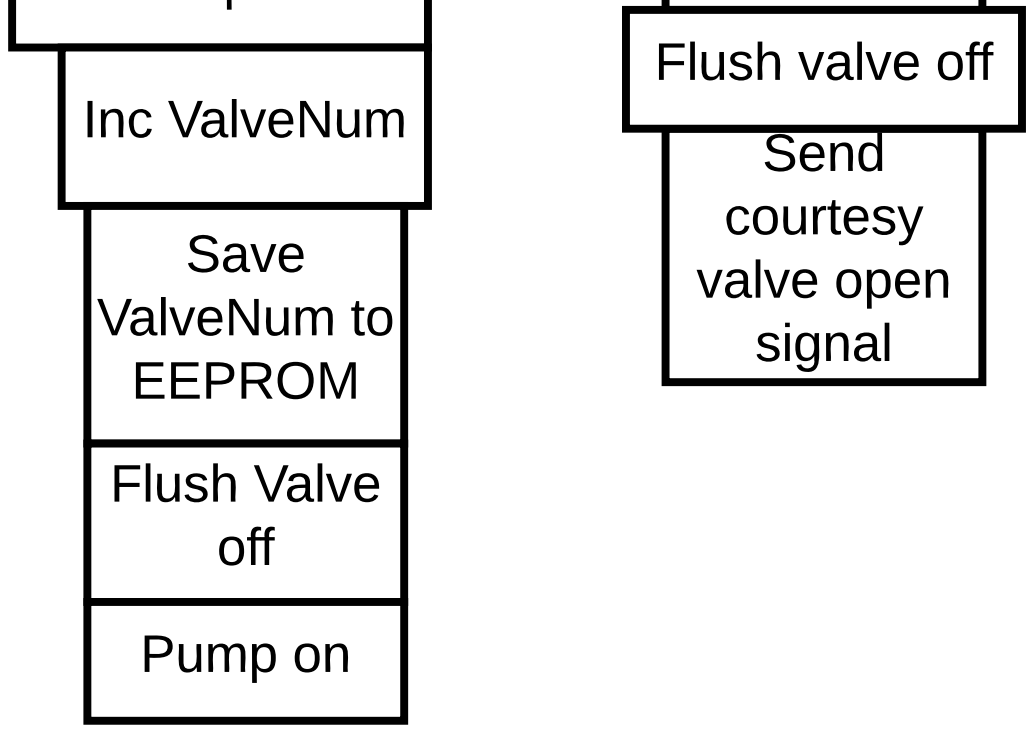
[picture p45: page 5]
Pump off; Inc ValveNum; Save ValveNum to EEPROM; Flush Valve off; Pump on

Flush valve off
Send
courtesy
valve open
signal

= False
