OPEnSLab-OSU/OPEnSampler/capstone/15mm Extrusion Base/PCBs/Main Control Board/july-10.brd

## EAGLE design capstone/15mm Extrusion Base/PCBs/Main Control Board/july-10.brd (2017-07-13)

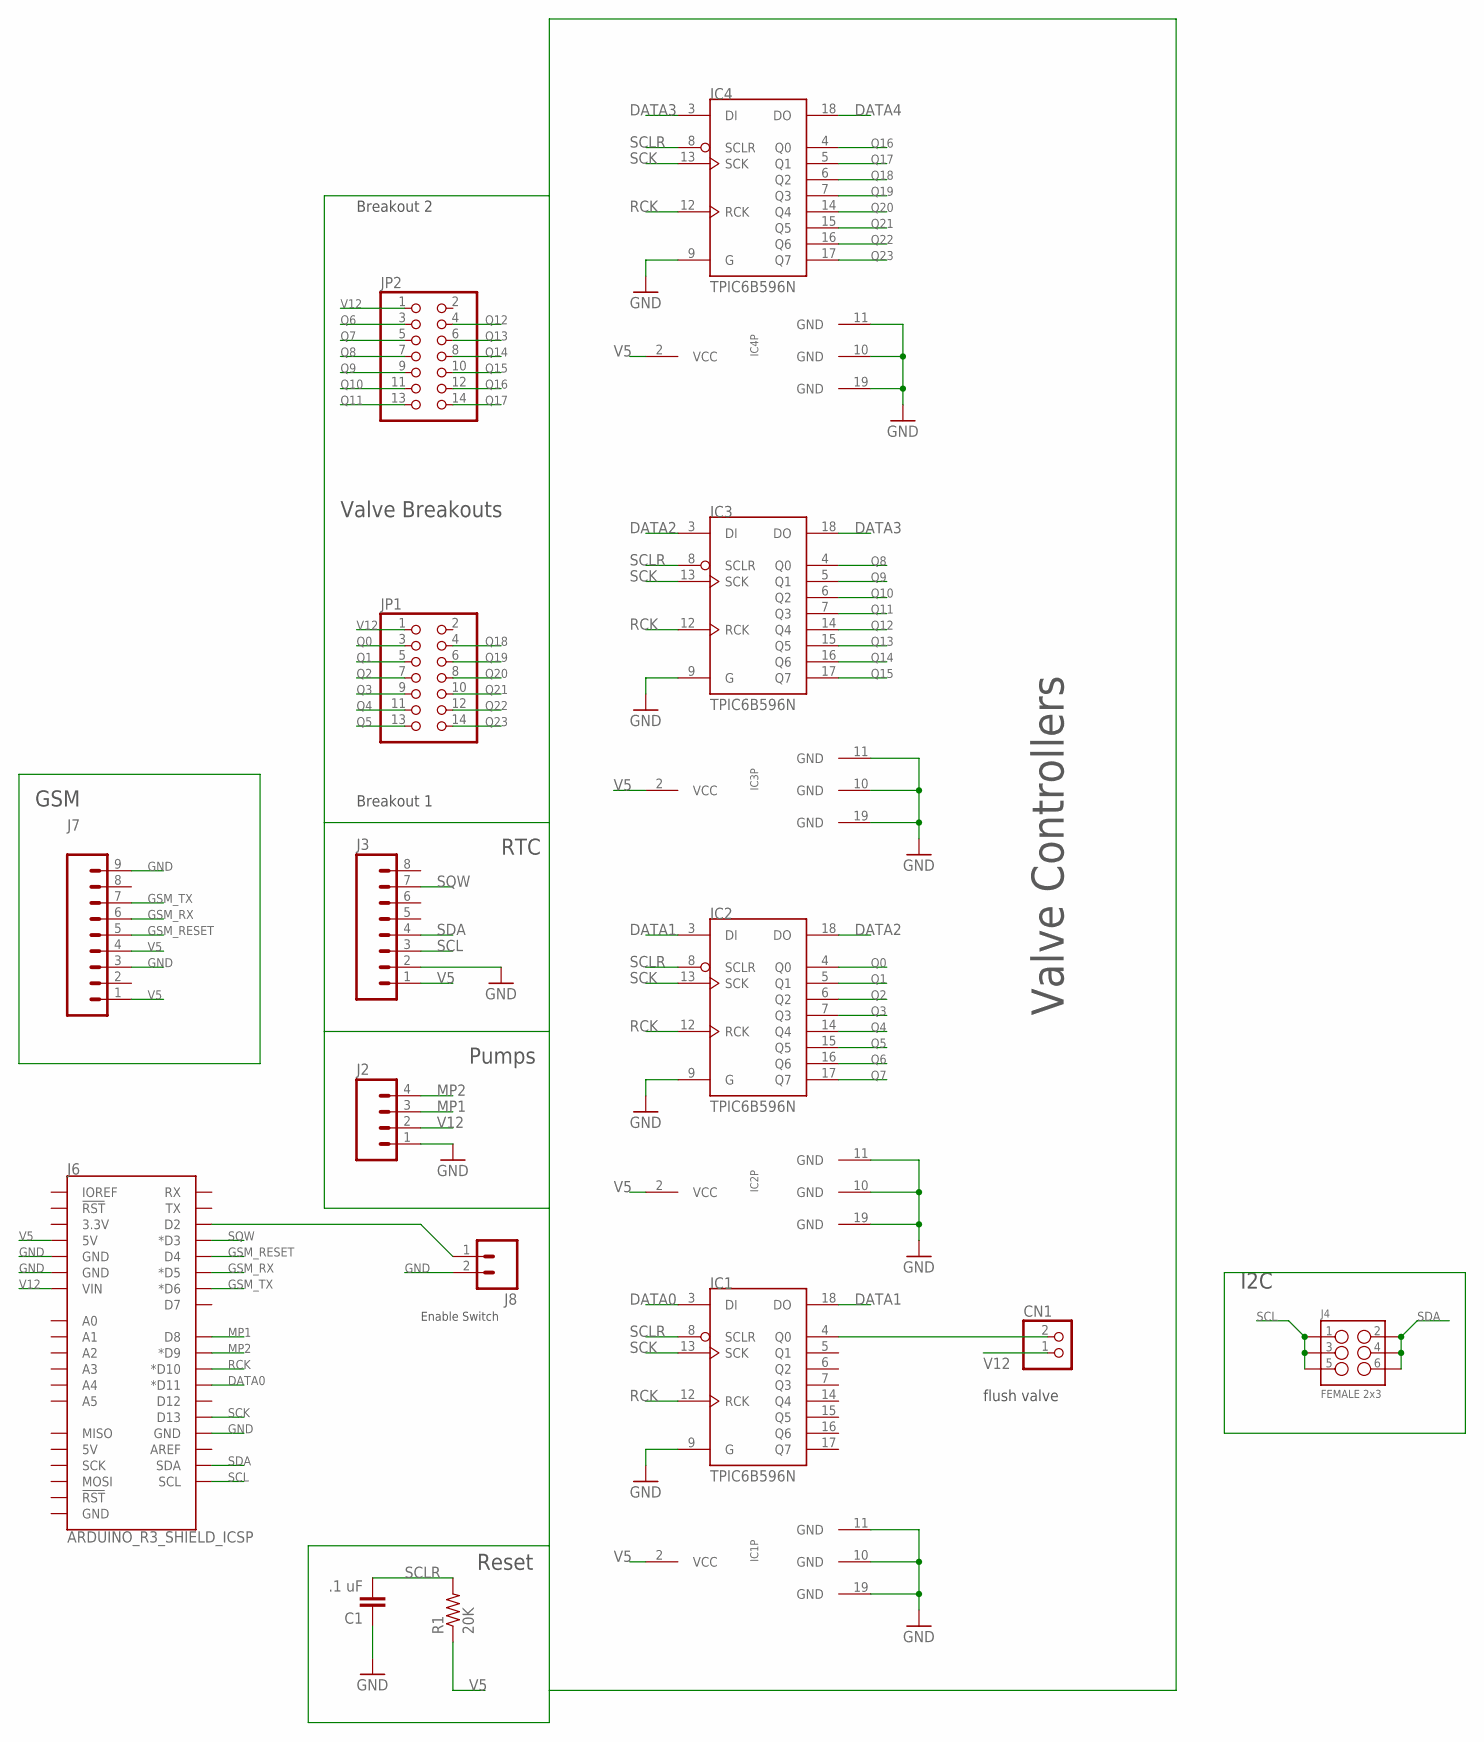
[picture p46: schematic july-10.sch]

Parts:
C1: .1 uF; AXIAL-5MM
CN1: JST_2PIN-THM; JST-PH-2-THM
IC1, IC2, IC3, IC4: TPIC6B596N; DIL20
J2: M04PTH; 1X04
J3: M08; 1X08_ROUND
J4: FEMALE 2x3; 2X3
J6: ARDUINO_R3_SHIELD_ICSP; UNO_R3_SHIELD_ICSP
J7: M09; 1X09
J8: M02PTH; 1X02
JP1, JP2: PINHD-2X7; 2X07
R1: 20K; AXIAL-0.4

Connections:
DATA0: IC1.3 (DI), J6.D11 (*D11)
DATA1: IC1.18 (DO), IC2.3 (DI)
DATA2: IC2.18 (DO), IC3.3 (DI)
DATA3: IC3.18 (DO), IC4.3 (DI)
DATA4: IC4.18 (DO)
GND: C1.P$1 (1), IC1.9 (G), IC1.10 (GND), IC1.11 (GND), IC1.19 (GND), IC2.9 (G), IC2.10 (GND), IC2.11 (GND), IC2.19 (GND), IC3.9 (G), IC3.10 (GND), IC3.11 (GND), IC3.19 (GND), IC4.9 (G), IC4.10 (GND), IC4.11 (GND), IC4.19 (GND), J2.1, J3.2, J6.GND@0 (GND), J6.GND@1 (GND), J6.GND@2 (GND), J7.3, J7.9, J8.2
GSM_RESET: J6.D4, J7.5
GSM_RX: J6.D5 (*D5), J7.6
GSM_TX: J6.D6 (*D6), J7.7
MP1: J2.3, J6.D8
MP2: J2.4, J6.D9 (*D9)
unnamed: CN1.2 (1), IC1.4 (Q0)
unnamed: J6.D2, J8.1
Q0: IC2.4 (Q0), JP1.3
Q1: IC2.5 (Q1), JP1.5
Q2: IC2.6 (Q2), JP1.7
Q3: IC2.7 (Q3), JP1.9
Q4: IC2.14 (Q4), JP1.11
Q5: IC2.15 (Q5), JP1.13
Q6: IC2.16 (Q6), JP2.3
Q7: IC2.17 (Q7), JP2.5
Q8: IC3.4 (Q0), JP2.7
Q9: IC3.5 (Q1), JP2.9
Q10: IC3.6 (Q2), JP2.11
Q11: IC3.7 (Q3), JP2.13
Q12: IC3.14 (Q4), JP2.4
Q13: IC3.15 (Q5), JP2.6
Q14: IC3.16 (Q6), JP2.8
Q15: IC3.17 (Q7), JP2.10
Q16: IC4.4 (Q0), JP2.12
Q17: IC4.5 (Q1), JP2.14
Q18: IC4.6 (Q2), JP1.4
Q19: IC4.7 (Q3), JP1.6
Q20: IC4.14 (Q4), JP1.8
Q21: IC4.15 (Q5), JP1.10
Q22: IC4.16 (Q6), JP1.12
Q23: IC4.17 (Q7), JP1.14
RCK: IC1.12 (RCK), IC2.12 (RCK), IC3.12 (RCK), IC4.12 (RCK), J6.D10 (*D10)
SCK: IC1.13 (SCK), IC2.13 (SCK), IC3.13 (SCK), IC4.13 (SCK), J6.D13
SCL: J3.3, J4.1, J4.3, J4.5, J6.SCL
SCLR: C1.P$2 (2), IC1.8 (SCLR), IC2.8 (SCLR), IC3.8 (SCLR), IC4.8 (SCLR), R1.P$2 (2)
SDA: J3.4, J4.2, J4.4, J4.6, J6.SDA
SQW: J3.7, J6.D3 (*D3)
V5: IC1.2 (VCC), IC2.2 (VCC), IC3.2 (VCC), IC4.2 (VCC), J3.1, J6.5V, J7.1, J7.4, R1.P$1 (1)
V12: CN1.1 (2), J2.2, J6.VIN, JP1.1, JP2.1

Notes on the sheet:
GSM
Valve Breakouts
Breakout 1
Breakout 2
RTC
Pumps
Reset
I2C
Valve Controllers
flush valve
Enable Switch

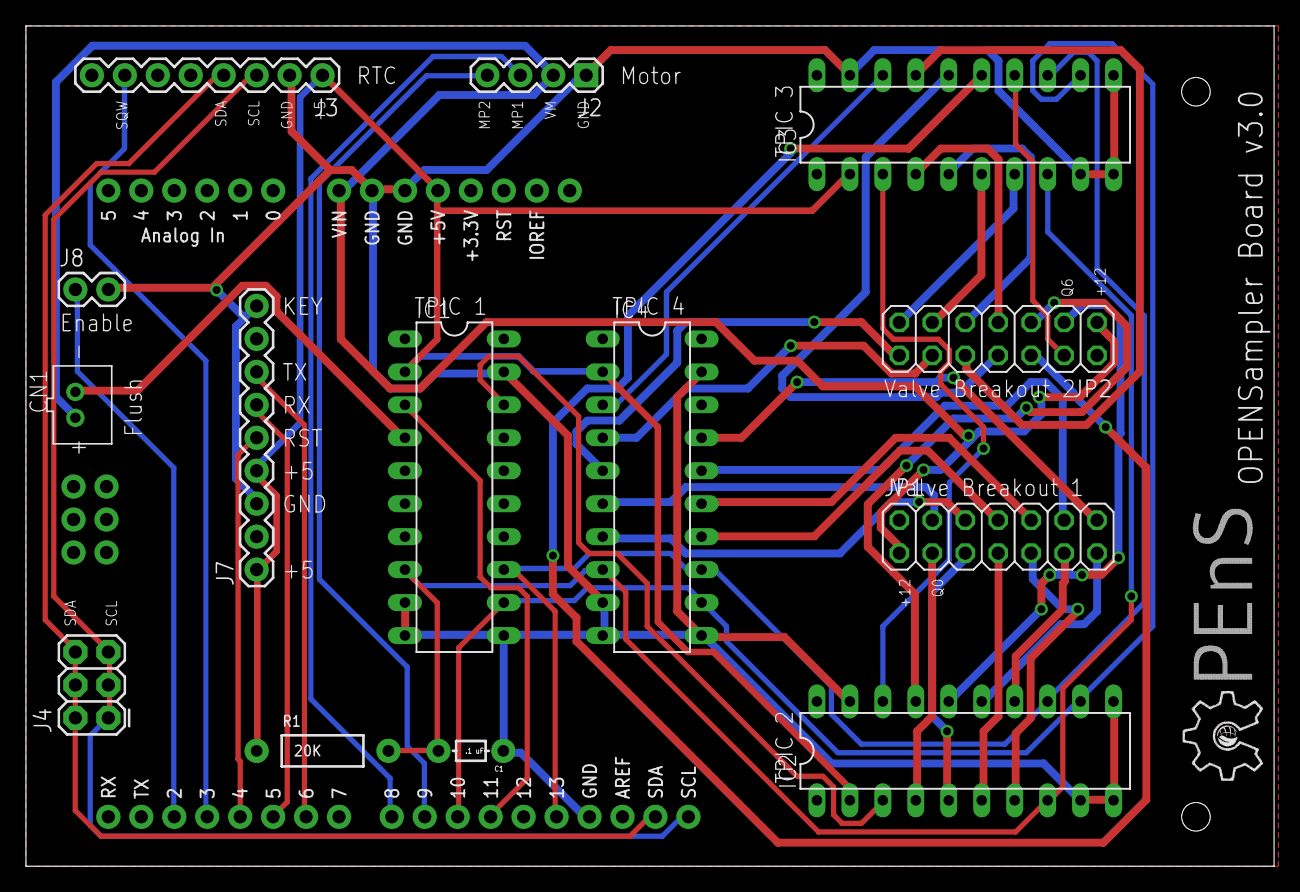
[picture p47: board july-10.brd from above]

Board: 2 copper layers, 96.2 x 64.8 mm, 16 parts (0 on the bottom side), 44 nets.

Other parts of the board:
U$1: OPENS-LOGO
