OPEnSLab-OSU/OPEnSampler/capstone/Water Sampler Schematics/apr-27.brd

## EAGLE design capstone/Water Sampler Schematics/apr-27.brd (2017-11-07)

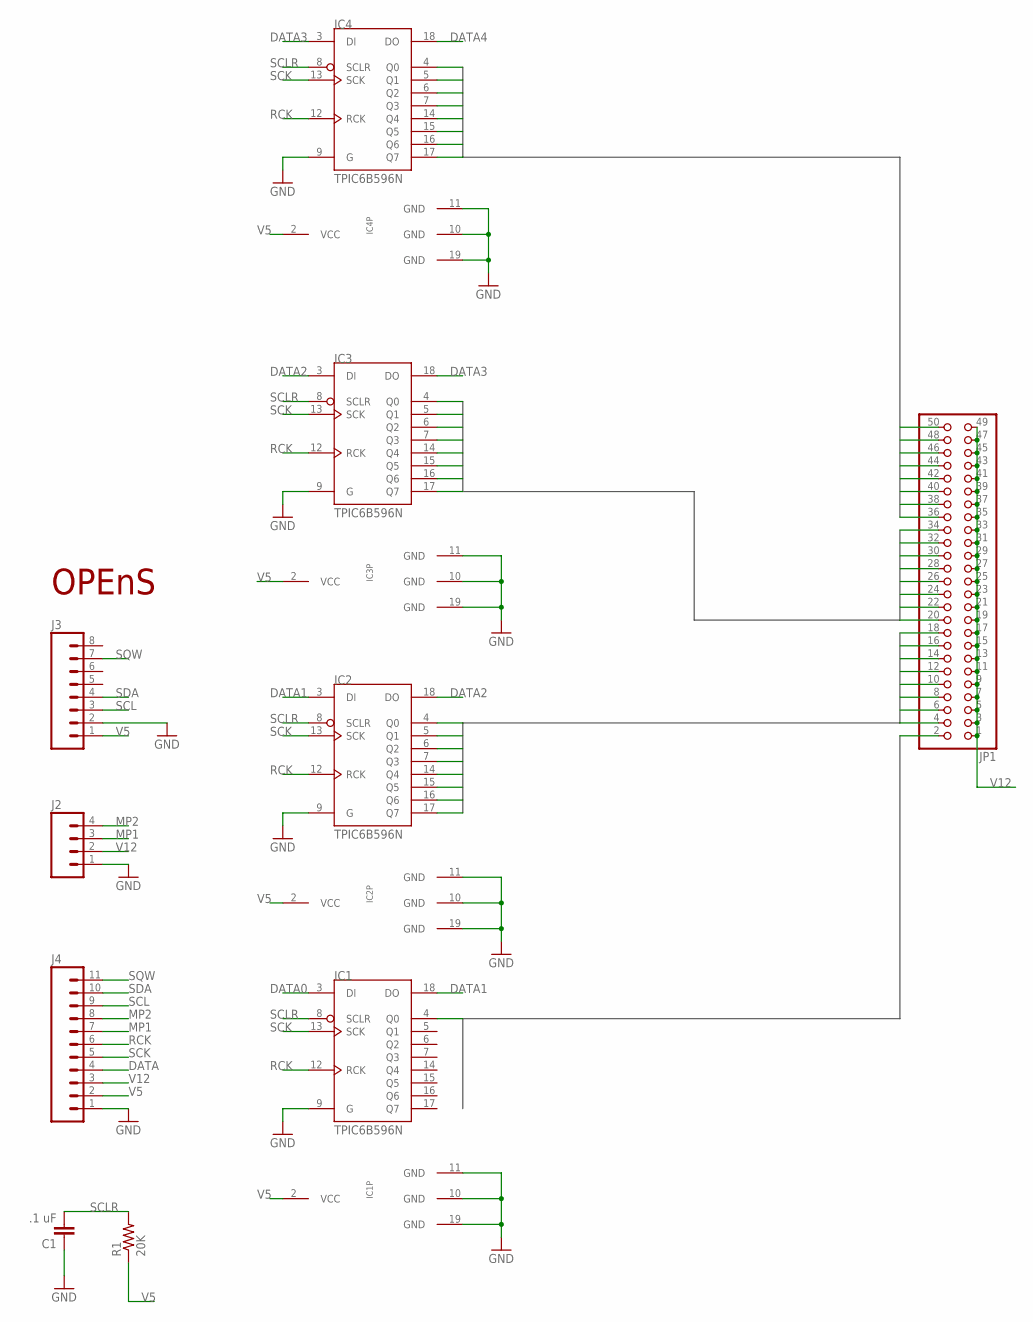
[picture p48: schematic apr-27.sch]

Parts:
C1: .1 uF; AXIAL-5MM
IC1, IC2, IC3, IC4: TPIC6B596N; DIL20
J2: M04PTH; 1X04
J3: M08; 1X08_ROUND
J4: M11PTH; 1X11
JP1: PINHD-2X25; 2X25
R1: 20K; AXIAL-0.4
U$1: OPENS-LOGO

Connections:
DATA: J4.4
DATA0: IC1.3 (DI)
DATA1: IC1.18 (DO), IC2.3 (DI)
DATA2: IC2.18 (DO), IC3.3 (DI)
DATA3: IC3.18 (DO), IC4.3 (DI)
DATA4: IC4.18 (DO)
GND: C1.P$1 (1), IC1.9 (G), IC1.10 (GND), IC1.11 (GND), IC1.19 (GND), IC2.9 (G), IC2.10 (GND), IC2.11 (GND), IC2.19 (GND), IC3.9 (G), IC3.10 (GND), IC3.11 (GND), IC3.19 (GND), IC4.9 (G), IC4.10 (GND), IC4.11 (GND), IC4.19 (GND), J2.1, J3.2, J4.1
MP1: J2.3, J4.7
MP2: J2.4, J4.8
Q0: IC1.4 (Q0), JP1.2
Q1: IC2.4 (Q0), JP1.4
Q2: IC2.5 (Q1), JP1.6
Q3: IC2.6 (Q2), JP1.8
Q4: IC2.7 (Q3), JP1.10
Q5: IC2.14 (Q4), JP1.12
Q6: IC2.15 (Q5), JP1.14
Q7: IC2.16 (Q6), JP1.16
Q8: IC2.17 (Q7), JP1.18
Q9: IC3.4 (Q0), JP1.20
Q10: IC3.5 (Q1), JP1.22
Q11: IC3.6 (Q2), JP1.24
Q12: IC3.7 (Q3), JP1.26
Q13: IC3.14 (Q4), JP1.28
Q14: IC3.15 (Q5), JP1.30
Q15: IC3.16 (Q6), JP1.32
Q16: IC3.17 (Q7), JP1.34
Q17: IC4.4 (Q0), JP1.36
Q18: IC4.5 (Q1), JP1.38
Q19: IC4.6 (Q2), JP1.40
Q20: IC4.7 (Q3), JP1.42
Q21: IC4.14 (Q4), JP1.44
Q22: IC4.15 (Q5), JP1.46
Q23: IC4.16 (Q6), JP1.48
Q24: IC4.17 (Q7), JP1.50
RCK: IC1.12 (RCK), IC2.12 (RCK), IC3.12 (RCK), IC4.12 (RCK), J4.6
SCK: IC1.13 (SCK), IC2.13 (SCK), IC3.13 (SCK), IC4.13 (SCK), J4.5
SCL: J3.3, J4.9
SCLR: C1.P$2 (2), IC1.8 (SCLR), IC2.8 (SCLR), IC3.8 (SCLR), IC4.8 (SCLR), R1.P$2 (2)
SDA: J3.4, J4.10
SQW: J3.7, J4.11
V5: IC1.2 (VCC), IC2.2 (VCC), IC3.2 (VCC), IC4.2 (VCC), J3.1, J4.2, R1.P$1 (1)
V12: J2.2, J4.3, JP1.1, JP1.3, JP1.5, JP1.7, JP1.9, JP1.11, JP1.13, JP1.15, JP1.17, JP1.19, JP1.21, JP1.23, JP1.25, JP1.27, JP1.29, JP1.31, JP1.33, JP1.35, JP1.37, JP1.39, JP1.41, JP1.43, JP1.45, JP1.47, JP1.49

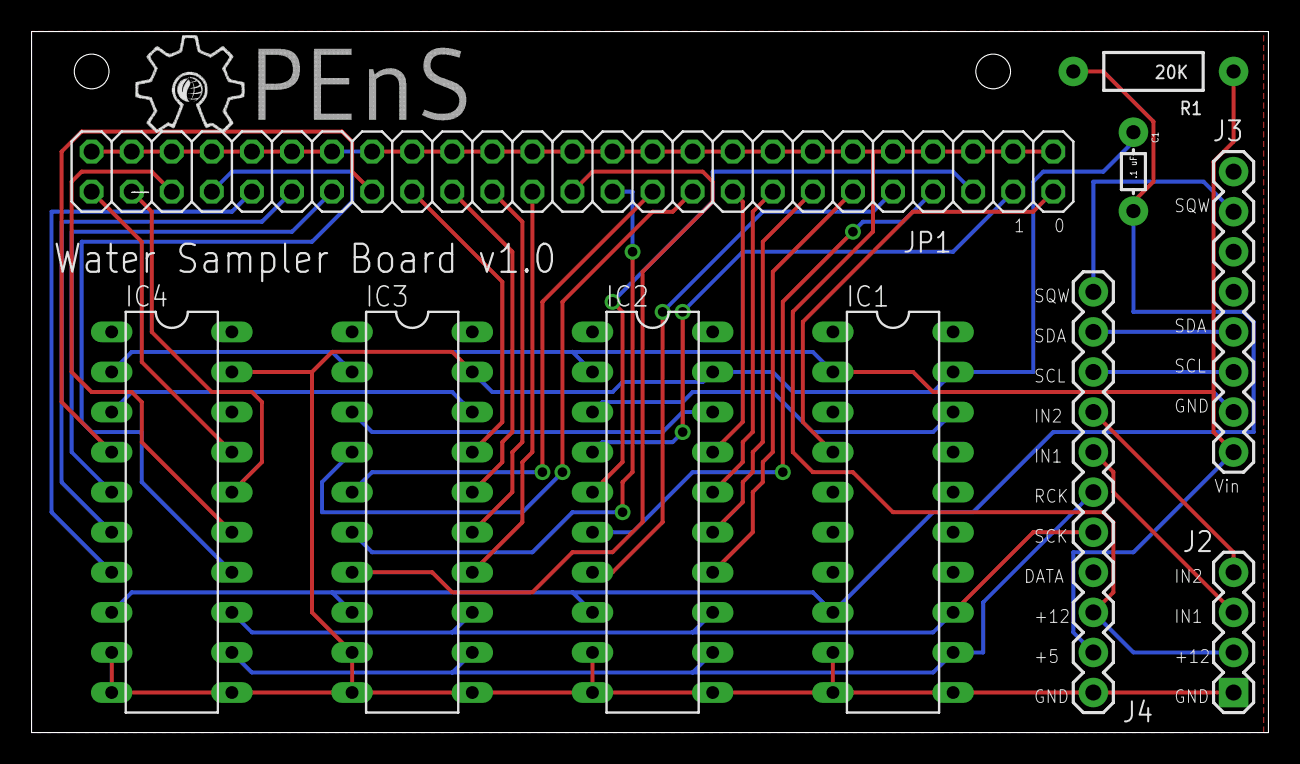
[picture p49: board apr-27.brd from above]

Board: 2 copper layers, 78.4 x 44.4 mm, 11 parts (0 on the bottom side), 39 nets.

Other parts of the board:
E$1: OPENS-LOGO
