OPEnSLab-OSU/OPEnSampler/capstone/15mm Extrusion Base/PCBs/Valve Breakout Board/VALVE BREAKOUT.brd

## EAGLE design capstone/15mm Extrusion Base/PCBs/Valve Breakout Board/VALVE BREAKOUT.brd (2017-07-13)

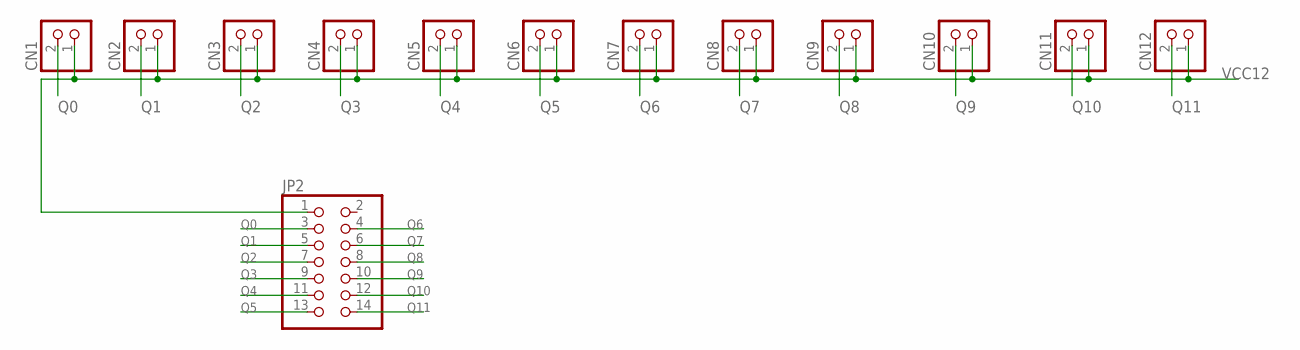
[picture p50: schematic VALVE BREAKOUT.sch]

Parts:
CN1, CN2, CN3, CN4, CN5, CN6, CN7, CN8, CN9, CN10, CN11, CN12: JST_2PIN-THM; JST-PH-2-THM
JP2: PINHD-2X7; 2X07

Connections:
Q0: CN1.2 (1), JP2.3
Q1: CN2.2 (1), JP2.5
Q2: CN3.2 (1), JP2.7
Q3: CN4.2 (1), JP2.9
Q4: CN5.2 (1), JP2.11
Q5: CN6.2 (1), JP2.13
Q6: CN7.2 (1), JP2.4
Q7: CN8.2 (1), JP2.6
Q8: CN9.2 (1), JP2.8
Q9: CN10.2 (1), JP2.10
Q10: CN11.2 (1), JP2.12
Q11: CN12.2 (1), JP2.14
VCC12: CN1.1 (2), CN2.1 (2), CN3.1 (2), CN4.1 (2), CN5.1 (2), CN6.1 (2), CN7.1 (2), CN8.1 (2), CN9.1 (2), CN10.1 (2), CN11.1 (2), CN12.1 (2), JP2.1

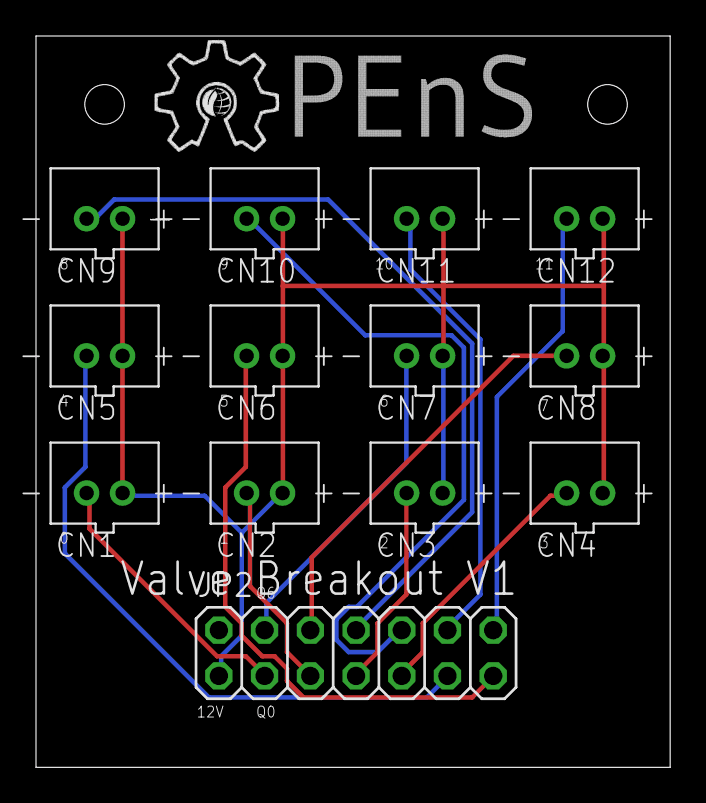
[picture p51: board VALVE BREAKOUT.brd from above]

Board: 2 copper layers, 35.2 x 40.6 mm, 14 parts (0 on the bottom side), 13 nets.

Other parts of the board:
U$1: OPENS-LOGO
