OPEnSLab-OSU/OPEnSampler/2018 Q1/EAGLE Files/OPEnSampler r2/March22.sch

## EAGLE design 2018 Q1/EAGLE Files/OPEnSampler r2/March22.sch (2018-04-04)

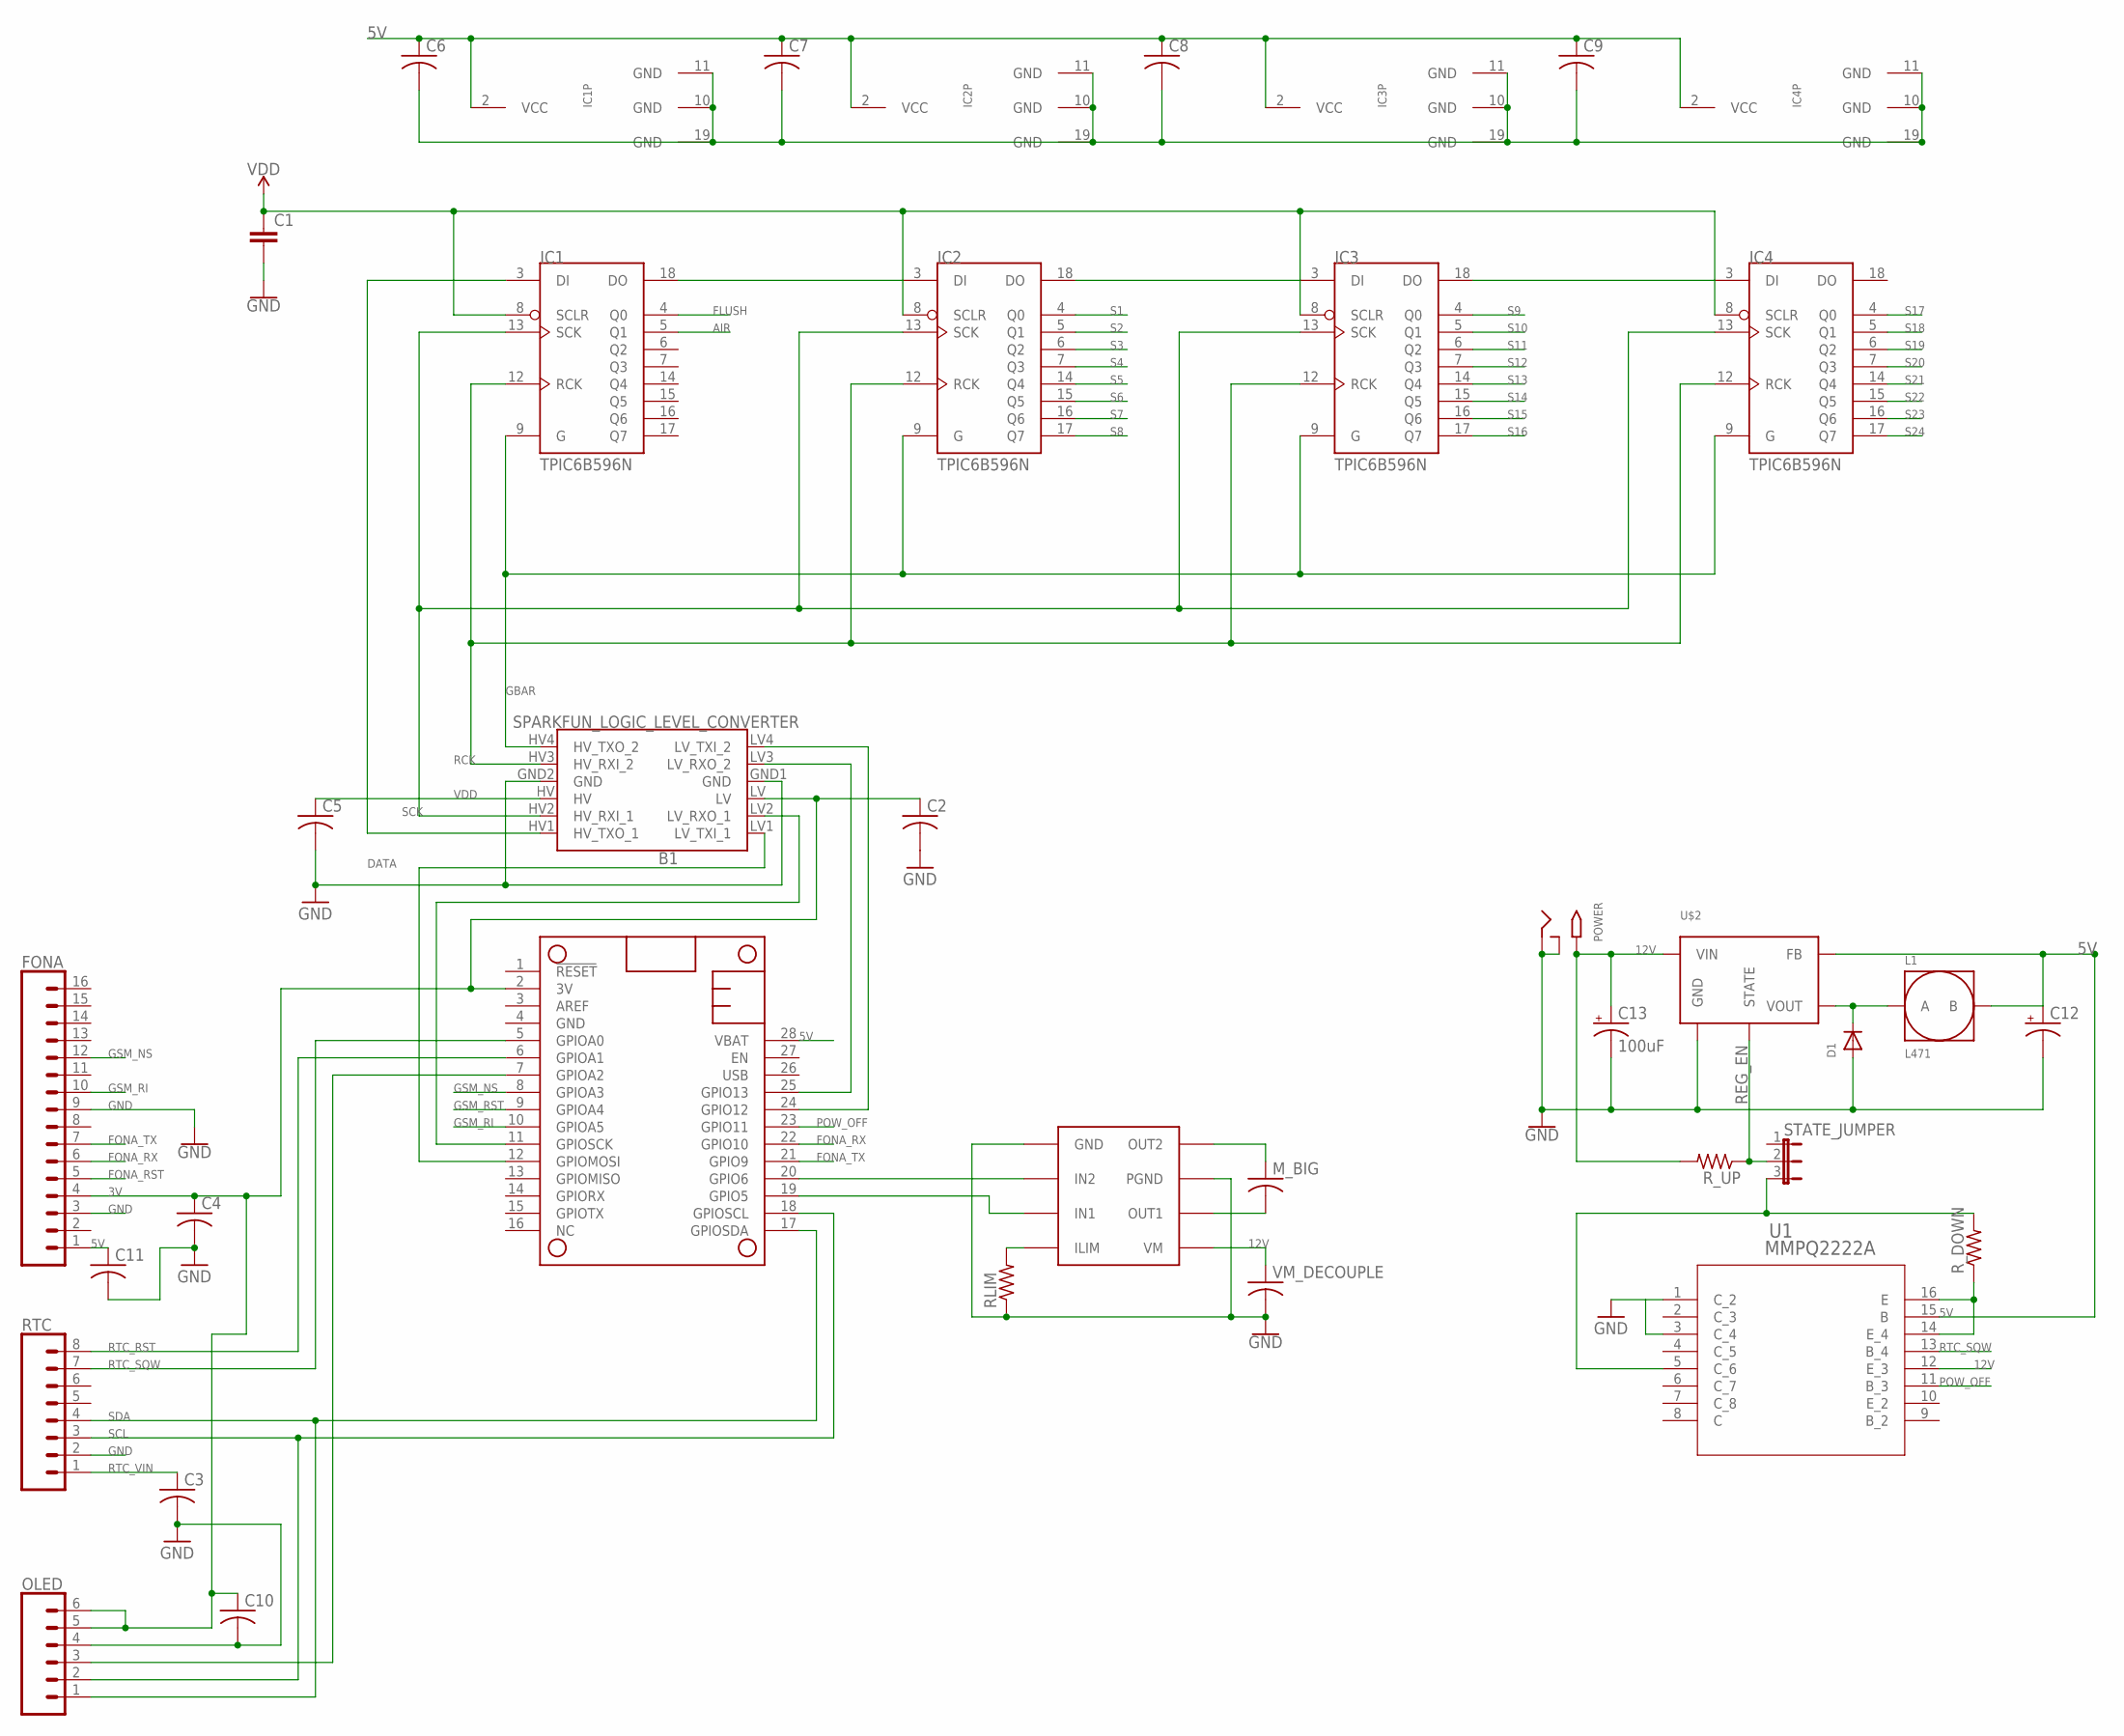
[picture p52: schematic March22.sch]

Parts:
B1: SPARKFUN_LOGIC_LEVEL_CONVERTER
C1: C2.5/5; C2.5-5
C2, C3, C4, C5, C6, C7, C8, C9, C10, C11: C-US025-025X050; C025-025X050
C12: CPOL-US140CLH-0810; 140CLH-0810
C13: 100uF; NIC_10X10.5_CAP
D1: DIODESOD-123; SOD-123
FONA: CONN_16; 1X16
IC1, IC2, IC3, IC4: TPIC6B596N; DIL20
L1: L471; 12-12
MS1: FEATHERWING
M_BIG: C-US025-025X050; C025-025X050
OLED: CONN_06SILK_FEMALE_PTH; 1X06
POWER: 2.1MMJACKSMT; DCJACK_2MM_SMT
RLIM: R-US_0204/7; 0204/7
RTC: CONN_08"; 1X08
R_DOWN: R-US_0204/7; 0204/7
R_UP: R-US_0204/7; 0204/7
STATE_JUMPER: JP2E; JP2
U1: MMPQ2222A; SO-G16
U$1: DRV8871
U$2: LM2575; TO-263
VM_DECOUPLE: C-US025-025X050; C025-025X050

Connections:
3V: B1.LV, C2.1, C4.1, C10.1, FONA.4, MS1.2 (3V), OLED.5, OLED.6
5V: C6.1, C7.1, C8.1, C9.1, C11.1, C12.+, FONA.1, IC1.2 (VCC), IC2.2 (VCC), IC3.2 (VCC), IC4.2 (VCC), L1.B, MS1.28 (VBAT), U1.15 (B), U$2.FB
12V: C13.+, POWER.PWR2 (TIP), R_UP.2, U1.12 (E_3), U$1.VM, U$2.VIN, VM_DECOUPLE.1
AIR: IC1.5 (Q1)
DATA: B1.HV1 (HV_TXO_1), IC1.3 (DI)
FLUSH: IC1.4 (Q0)
FONA_RST: FONA.5
FONA_RX: FONA.6, MS1.22 (GPIO10)
FONA_TX: FONA.7, MS1.21 (GPIO9)
GBAR: B1.HV4 (HV_TXO_2), IC1.9 (G), IC2.9 (G), IC3.9 (G), IC4.9 (G)
GND: B1.GND1 (GND), B1.GND2 (GND), C1.2, C2.2, C3.2, C4.2, C5.2, C10.2, C11.2, C12.-, C13.-, D1.A, FONA.3, FONA.9, OLED.4, POWER.GND (RING), POWER.GNDBREAK (RING_SW), RLIM.1, RTC.2, U1.1 (C_2), U1.3 (C_4), U$1.GND, U$1.PGND, U$2.GND, VM_DECOUPLE.2
GSM_NS: FONA.12, MS1.8 (GPIOA3)
GSM_RI: FONA.10, MS1.10 (GPIOA5)
GSM_RST: MS1.9 (GPIOA4)
unnamed: B1.LV1 (LV_TXI_1), MS1.12 (GPIOMOSI)
unnamed: IC1.18 (DO), IC2.3 (DI)
unnamed: IC2.18 (DO), IC3.3 (DI)
unnamed: B1.LV4 (LV_TXI_2), MS1.24 (GPIO12)
unnamed: IC3.18 (DO), IC4.3 (DI)
unnamed: B1.LV3 (LV_RXO_2), MS1.25 (GPIO13)
unnamed: C6.2, C7.2, C8.2, C9.2, IC1.10 (GND), IC1.11 (GND), IC1.19 (GND), IC2.10 (GND), IC2.11 (GND), IC2.19 (GND), IC3.10 (GND), IC3.11 (GND), IC3.19 (GND), IC4.10 (GND), IC4.11 (GND), IC4.19 (GND)
unnamed: D1.C, L1.A, U$2.VOUT
unnamed: R_UP.1, STATE_JUMPER.2, U$2.STATE
unnamed: MS1.20 (GPIO6), U$1.IN2
unnamed: MS1.19 (GPIO5), U$1.IN1
unnamed: RLIM.2, U$1.ILIM
unnamed: M_BIG.2, U$1.OUT1
unnamed: R_DOWN.1, U1.14 (E_4), U1.16 (E)
unnamed: M_BIG.1, U$1.OUT2
unnamed: MS1.7 (GPIOA2), OLED.3
unnamed: B1.LV2 (LV_RXO_1), MS1.11 (GPIOSCK)
POW_OFF: MS1.23 (GPIO11), U1.11 (B_3)
RCK: B1.HV3 (HV_RXI_2), IC1.12 (RCK), IC2.12 (RCK), IC3.12 (RCK), IC4.12 (RCK)
REG_EN: R_DOWN.2, STATE_JUMPER.3, U1.5 (C_6)
RTC_RST: MS1.6 (GPIOA1), RTC.8
RTC_SQW: MS1.5 (GPIOA0), RTC.7, U1.13 (B_4)
RTC_VIN: C3.1, RTC.1
S1: IC2.4 (Q0)
S2: IC2.5 (Q1)
S3: IC2.6 (Q2)
S4: IC2.7 (Q3)
S5: IC2.14 (Q4)
S6: IC2.15 (Q5)
S7: IC2.16 (Q6)
S8: IC2.17 (Q7)
S9: IC3.4 (Q0)
S10: IC3.5 (Q1)
S11: IC3.6 (Q2)
S12: IC3.7 (Q3)
S13: IC3.14 (Q4)
S14: IC3.15 (Q5)
S15: IC3.16 (Q6)
S16: IC3.17 (Q7)
S17: IC4.4 (Q0)
S18: IC4.5 (Q1)
S19: IC4.6 (Q2)
S20: IC4.7 (Q3)
S21: IC4.14 (Q4)
S22: IC4.15 (Q5)
S23: IC4.16 (Q6)
S24: IC4.17 (Q7)
SCK: B1.HV2 (HV_RXI_1), IC1.13 (SCK), IC2.13 (SCK), IC3.13 (SCK), IC4.13 (SCK)
SCL: MS1.18 (GPIOSCL), OLED.2, RTC.3
SDA: MS1.17 (GPIOSDA), OLED.1, RTC.4
VDD: B1.HV, C1.1, C5.1, IC1.8 (SCLR), IC2.8 (SCLR), IC3.8 (SCLR), IC4.8 (SCLR)
