OPEnSLab-OSU/OPEnSampler/capstone/OpenSampler/app/src/main/java/opensampler/opensampler/BluetoothService.java

/* Some of the code used in this application falls under the copyright notice below. To view the original source code please use the following link:
 * https://github.com/NordicPlayground/Android-nRF-UART
 *
 * Copyright (c) 2015, Nordic Semiconductor
 * All rights reserved.
 *
 * Redistribution and use in source and binary forms, with or without modification, are permitted provided that the following conditions are met:
 *
 * 1. Redistributions of source code must retain the above copyright notice, this list of conditions and the following disclaimer.
 *
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
 * 3. Neither the name of the copyright holder nor the names of its contributors may be used to endorse or promote products derived from this
 * software without specific prior written permission.
 *
 * THIS SOFTWARE IS PROVIDED BY THE COPYRIGHT HOLDERS AND CONTRIBUTORS "AS IS" AND ANY EXPRESS OR IMPLIED WARRANTIES, INCLUDING, BUT NOT
 * LIMITED TO, THE IMPLIED WARRANTIES OF MERCHANTABILITY AND FITNESS FOR A PARTICULAR PURPOSE ARE DISCLAIMED. IN NO EVENT SHALL THE COPYRIGHT
 * HOLDER OR CONTRIBUTORS BE LIABLE FOR ANY DIRECT, INDIRECT, INCIDENTAL, SPECIAL, EXEMPLARY, OR CONSEQUENTIAL DAMAGES (INCLUDING, BUT NOT
 * LIMITED TO, PROCUREMENT OF SUBSTITUTE GOODS OR SERVICES; LOSS OF USE, DATA, OR PROFITS; OR BUSINESS INTERRUPTION) HOWEVER CAUSED AND ON
 * ANY THEORY OF LIABILITY, WHETHER IN CONTRACT, STRICT LIABILITY, OR TORT (INCLUDING NEGLIGENCE OR OTHERWISE) ARISING IN ANY WAY OUT OF THE
 * USE OF THIS SOFTWARE, EVEN IF ADVISED OF THE POSSIBILITY OF SUCH DAMAGE.
 */

package opensampler.opensampler;

import android.app.Service;
import android.bluetooth.BluetoothAdapter;
import android.bluetooth.BluetoothDevice;
import android.bluetooth.BluetoothGatt;
import android.bluetooth.BluetoothGattCallback;
import android.bluetooth.BluetoothGattCharacteristic;
import android.bluetooth.BluetoothGattDescriptor;
import android.bluetooth.BluetoothGattService;
import android.bluetooth.BluetoothManager;
import android.bluetooth.BluetoothProfile;
import android.content.Context;
import android.content.Intent;
import android.os.Binder;
import android.os.IBinder;
import android.support.v4.content.LocalBroadcastManager;
import android.util.Log;
import java.util.List;
import java.util.UUID;
import android.annotation.TargetApi;
import static android.content.ContentValues.TAG;

/**
 * Created by hunter on 2/14/18.
 */

public class BluetoothService extends Service {
    //variables for managing bluetooth
    private BluetoothManager mBluetoothManager;
    private BluetoothAdapter mBluetoothAdapter;
    private String mBluetoothDeviceAddress;
    private BluetoothGatt mBluetoothGatt;
    private int mConnectionState = STATE_DISCONNECTED;

    private static final int STATE_DISCONNECTED = 0;
    private static final int STATE_CONNECTING = 1;
    private static final int STATE_CONNECTED = 2;

    public final static String ACTION_GATT_CONNECTED =
            "com.nordicsemi.nrfUART.ACTION_GATT_CONNECTED";
    public final static String ACTION_GATT_DISCONNECTED =
            "com.nordicsemi.nrfUART.ACTION_GATT_DISCONNECTED";
    public final static String ACTION_GATT_SERVICES_DISCOVERED =
            "com.nordicsemi.nrfUART.ACTION_GATT_SERVICES_DISCOVERED";
    public final static String ACTION_DATA_AVAILABLE =
            "com.nordicsemi.nrfUART.ACTION_DATA_AVAILABLE";
    public final static String EXTRA_DATA =
            "com.nordicsemi.nrfUART.EXTRA_DATA";
    public final static String DEVICE_DOES_NOT_SUPPORT_UART =
            "com.nordicsemi.nrfUART.DEVICE_DOES_NOT_SUPPORT_UART";

    public static final UUID TX_POWER_UUID = UUID.fromString("00001804-0000-1000-8000-00805f9b34fb");
    public static final UUID TX_POWER_LEVEL_UUID = UUID.fromString("00002a07-0000-1000-8000-00805f9b34fb");
    public static final UUID CCCD = UUID.fromString("00002902-0000-1000-8000-00805f9b34fb");
    public static final UUID FIRMWARE_REVISON_UUID = UUID.fromString("00002a26-0000-1000-8000-00805f9b34fb");
    public static final UUID DIS_UUID = UUID.fromString("0000180a-0000-1000-8000-00805f9b34fb");
    public static final UUID RX_SERVICE_UUID = UUID.fromString("6e400001-b5a3-f393-e0a9-e50e24dcca9e");
    public static final UUID RX_CHAR_UUID = UUID.fromString("6e400002-b5a3-f393-e0a9-e50e24dcca9e");
    public static final UUID TX_CHAR_UUID = UUID.fromString("6e400003-b5a3-f393-e0a9-e50e24dcca9e");

    //Various callback methods that are defined by the BLE api
    //When any callback is triggered it calls the appropriate broadcast manager
    private final BluetoothGattCallback mGattCallback = new BluetoothGattCallback() {
        @TargetApi(18)
        @Override
        public void onConnectionStateChange(BluetoothGatt gatt, int status,
                                            int newState) {
            String intentAction;
            if (newState == BluetoothProfile.STATE_CONNECTED) {
                intentAction = ACTION_GATT_CONNECTED;
                mConnectionState = STATE_CONNECTED;
                broadcastUpdate(intentAction);
                Log.i(TAG, ACTION_GATT_CONNECTED + "\n");
                Log.i(TAG, "Connected to GATT server. action = " + intentAction);
                Log.i(TAG, "Attempting to start service discovery:" +
                        mBluetoothGatt.discoverServices());
                //App tells you the address of the bluetooth device you connected to

            } else if (newState == BluetoothProfile.STATE_DISCONNECTED) {
                intentAction = ACTION_GATT_DISCONNECTED;
                mConnectionState = STATE_DISCONNECTED;
                Log.i(TAG, "Disconnected from GATT server.");
                broadcastUpdate(intentAction);
            }
        }

        @Override
        // New services discovered
        public void onServicesDiscovered(BluetoothGatt gatt, int status) {
            if (status == BluetoothGatt.GATT_SUCCESS) {
                Log.w(TAG, "mBluetoothGatt = " + mBluetoothGatt );
                broadcastUpdate(ACTION_GATT_SERVICES_DISCOVERED);
            } else {
                Log.w(TAG, "onServicesDiscovered received: " + status);
            }
        }

        @Override
        // Result of a characteristic read operation
        public void onCharacteristicRead(BluetoothGatt gatt,
                                         BluetoothGattCharacteristic characteristic,
                                         int status) {
            if (status == BluetoothGatt.GATT_SUCCESS) {
                broadcastUpdate(ACTION_DATA_AVAILABLE, characteristic);
            }
        }

        @Override
        public void onCharacteristicChanged(BluetoothGatt gatt,
                                            BluetoothGattCharacteristic characteristic) {
            broadcastUpdate(ACTION_DATA_AVAILABLE, characteristic);
        }
    };

    private void broadcastUpdate(final String action) {
        final Intent intent = new Intent(action);
        Log.d(TAG, "Sending broadcast1" + action);
        LocalBroadcastManager.getInstance(this).sendBroadcast(intent);
    }

    private void broadcastUpdate(final String action,
                                 final BluetoothGattCharacteristic characteristic) {
        final Intent intent = new Intent(action);
        Log.d(TAG, "Sending broadcast2");
        LocalBroadcastManager.getInstance(this).sendBroadcast(intent);
    }

    public class LocalBinder extends Binder {
        public BluetoothService getService() {
            return BluetoothService.this;
        }
    }

    @Override
    public IBinder onBind(Intent intent) {
        return mBinder;
    }

    @Override
    public boolean onUnbind(Intent intent) {
        // After using a given device, you should make sure that BluetoothGatt.close() is called
        // such that resources are cleaned up properly.  In this particular example, close() is
        // invoked when the UI is disconnected from the Service.
        close();
        return super.onUnbind(intent);
    }

    private final IBinder mBinder = new LocalBinder();

    @TargetApi(18)
    public boolean initialize() {
        if (mBluetoothManager == null) {
            mBluetoothManager = (BluetoothManager) getSystemService(Context.BLUETOOTH_SERVICE);
            if(mBluetoothManager == null) {
                Log.e(TAG, "BluetoothManager could not eb initialized.");
                return false;
            }
        }

        mBluetoothAdapter = mBluetoothManager.getAdapter();
        if(mBluetoothAdapter == null){
            Log.e(TAG, "BluetoothAdapter could not be obtained");
            return false;
        }
        return true;
    }

    @TargetApi(18)
    public boolean connect(final String address) {
        if (mBluetoothAdapter == null || address == null) {
            Log.w(TAG, "BluetoothAdapter not initialized or unspecified address.");
            return false;
        }

        // Previously connected device.  Try to reconnect.
        if (mBluetoothDeviceAddress != null && address.equals(mBluetoothDeviceAddress)
                && mBluetoothGatt != null) {
            Log.d(TAG, "Trying to use an existing mBluetoothGatt for connection.");
            if (mBluetoothGatt.connect()) {
                mConnectionState = STATE_CONNECTING;
                return true;
            } else {
                return false;
            }
        }

        final BluetoothDevice device = mBluetoothAdapter.getRemoteDevice(address);
        if (device == null) {
            Log.w(TAG, "Device not found.  Unable to connect.");
            return false;
        }
        // We want to directly connect to the device, so we are setting the autoConnect
        // parameter to false.
        mBluetoothGatt = device.connectGatt(this, false, mGattCallback);
        Log.d(TAG, "Trying to create a new connection.");
        mBluetoothDeviceAddress = address;
        mConnectionState = STATE_CONNECTING;
        return true;
    }

    @TargetApi(18)
    public void disconnect() {
        if (mBluetoothAdapter == null || mBluetoothGatt == null) {
            Log.w(TAG, "BluetoothAdapter not initialized");
            return;
        }
        mBluetoothGatt.disconnect();
        // mBluetoothGatt.close();
    }

    @TargetApi(18)
    public void close() {
        if (mBluetoothGatt == null) {
            return;
        }
        mBluetoothGatt.close();
        mBluetoothGatt = null;
    }

    @TargetApi(18)
    public void readCharacteristic(BluetoothGattCharacteristic characteristic) {
        if (mBluetoothAdapter == null || mBluetoothGatt == null) {
            Log.w(TAG, "BluetoothAdapter not initialized");
            return;
        }
        mBluetoothGatt.readCharacteristic(characteristic);
    }

    @TargetApi(18)
    public void enableTXNotification()
    {
        BluetoothGattService RxService = mBluetoothGatt.getService(RX_SERVICE_UUID);
        if (RxService == null) {
            showMessage("Rx service not found!");
            broadcastUpdate(DEVICE_DOES_NOT_SUPPORT_UART);
            return;
        }
        BluetoothGattCharacteristic TxChar = RxService.getCharacteristic(TX_CHAR_UUID);
        if (TxChar == null) {
            showMessage("Tx charateristic not found!");
            broadcastUpdate(DEVICE_DOES_NOT_SUPPORT_UART);
            return;
        }
        mBluetoothGatt.setCharacteristicNotification(TxChar,true);

        BluetoothGattDescriptor descriptor = TxChar.getDescriptor(CCCD);
        descriptor.setValue(BluetoothGattDescriptor.ENABLE_NOTIFICATION_VALUE);
        mBluetoothGatt.writeDescriptor(descriptor);

    }

    @TargetApi(18)
    public void writeRXCharacteristic(byte[] value)
    {
        BluetoothGattService RxService = mBluetoothGatt.getService(RX_SERVICE_UUID);
        showMessage("mBluetoothGatt null"+ mBluetoothGatt);
        if (RxService == null) {
            showMessage("Rx service not found!");
            broadcastUpdate(DEVICE_DOES_NOT_SUPPORT_UART);
            return;
        }
        BluetoothGattCharacteristic RxChar = RxService.getCharacteristic(RX_CHAR_UUID);
        if (RxChar == null) {
            showMessage("Rx charateristic not found!");
            broadcastUpdate(DEVICE_DOES_NOT_SUPPORT_UART);
            return;
        }
        RxChar.setValue(value);
        boolean status = mBluetoothGatt.writeCharacteristic(RxChar);

        Log.d(TAG, "write TXchar - status=" + status);
    }

    private void showMessage(String msg) {
        Log.e(TAG, msg);
    }
    //Retrieves a list of supported GATT services on the connected device. This should be

    @TargetApi(18)
    public List<BluetoothGattService> getSupportedGattServices() {
        if (mBluetoothGatt == null) return null;

        return mBluetoothGatt.getServices();
    }
}
