OPEnSLab-OSU/OPEnSampler/capstone/ArduinoCode/SamplerSerialEverythingV1.9OptoRTC/Configuration.h

#pragma once

#include <stdint.h>

#include "Defaults.h"

enum class Mode {DAILY, PERIODIC};

// Values are stored in a struct within the Configuration class to make them easy to copy to/from EEPROM
struct config_t {
  Mode mode; // Daily or Periodic sample timer
  bool written; // Has EEPROM been written to?
  uint8_t sampleAlarmHour;   // Hour   to take a sample
  uint8_t sampleAlarmMinute; // Minute to take a sample
  uint16_t periodicAlarmMinutes; // Time (in minutes) between samples in Periodic mode
  unsigned long flushDurationMs; // How long to perform a flush (in milliseconds)
  unsigned long sampleDurationMs; // How long to draw a sample (in milliseconds)
  uint8_t valveNumber; // Current number of valves sampled, 0=reset/default
  char SMSNumbers[numSMSRecipients][phoneNumberLength+1]; // Phone numbers for SMS status update recipients
};

/**
 * Stores OPEnSampler's configuration values
 *
 * Storing configuration in this class (as opposed to global struct like in earlier iterations) ensures these
 * values are accessed/updated/validated consistently.
 */
class Configuration
{
public:
  void setDefaults();

  void getConfigData(uint8_t data[]);

  void setDailyAlarm(unsigned int hour, unsigned int minute);

  void setPeriodicAlarm(unsigned int minutes);
  void refreshPeriodicAlarm();

  void setMode(Mode mode);
  void setWritten(bool written);
  void setSampleDuration(unsigned long milliseconds);
  void setFlushDuration(unsigned long milliseconds);
  uint8_t setSampleHour(unsigned int hour);
  uint8_t setSampleMinute(unsigned int minute);
  void setSMSNumber(int index, char *buffer);
  void setValveNumber(unsigned int valveNumber);

  Mode getMode();
  bool getWritten();
  unsigned long getFlushDuration();
  unsigned long getSampleDuration();
  uint8_t getSampleHour();
  uint8_t getSampleMinute();
  char * getSMSNumber(int index);
  uint16_t getPeriodicAlarmLength();
  uint8_t getValveNumber();

  void readFromEEPROM();
  void writeToEEPROM();

private:
  // This is stored as a struct so it can be easily written to EEPROM.
  config_t configData;
};
