OPEnSLab-OSU/OPEnSampler/capstone/ArduinoCode/SamplerSerialEverythingV1.9OptoRTC/StatusUpdates.ino

#if FONA_ENABLED

#include "Globals.h"

// https://github.com/adafruit/Adafruit_FONA/blob/master/examples/FONAtest/FONAtest.ino#L269
enum NetworkStatus { NOT_REGISTERED           = 0,
                     REGISTERED_HOME          = 1,
                     NOT_REGISTERED_SEARCHING = 2,
                     DENIED                   = 3,
                     NOT_KNOWN                = 4,
                     REGISTERED_ROAMING       = 5 };

/**
 * Send an SMS message to all stored phone numbers.
 */
void sendSMSAll(char * message)
{
  // Send SMS to each recipient
  for (unsigned int i = 0; i < numSMSRecipients; i++) {
    NetworkStatus status = (NetworkStatus) fona.getNetworkStatus();
    
    // Delay briefly while waiting for good network status
    const unsigned int seconds = 10;
    for (unsigned int count = 0; count <= seconds; count++) {

      if (status == REGISTERED_HOME || status == REGISTERED_ROAMING) break;

#ifdef DEBUG
      Serial.println(F("DEBUG: Network not ready to send SMS, delaying 1s"));
#endif

      delay(1000);
      status = (NetworkStatus) fona.getNetworkStatus();
    }

    // Done waiting, send it now
    char * phoneNumber = config.getSMSNumber(i);

    if (phoneNumber) {
#ifdef DEBUG
        Serial.print(F("DEBUG: Attempting to send SMS to "));
        Serial.print(phoneNumber);
#endif

      if (!fona.sendSMS(phoneNumber, message)) {
        Serial.print(F("ERROR: FONA library reported problems sending SMS to "));
        Serial.println(phoneNumber);
        Serial.println(F("(It may go through anyways.)"));
      }
    }
  }
}
#endif
