OPEnSLab-OSU/OPEnSampler/(commit log)

2017-11-07 Unified and cleaned up duplicates for prior 2 split repositories.
    Took all files from WaterSampler repository except Arduino code since that was a prior version. Unzipped Arduino code to make more transparent versioning.
    [2pump_mount_3030.stl, Base_Unit schematic.sch, Extension_Unit Schematic.sch, T_bracket_4040-3030.stl, apr-27.brd, apr-27.sch, arduino_mount.stl, board_mount.stl]
2017-11-14 Updated to OPEnSampler Q4 2017
    Removed irrelevant files that didn't need to be shared. Removed OPEnSampler 4040 files and replaced with OPEnSampler Q4 2017 files (15mm extrusion). Added CAD files and BoM, along with Printed Component STLs and info sheets.
    [2pump_mount_3030.stl, Bag Cap 10.stl, Bag Cap Inner July 13.stl, Bag Cap July 13.f3d, Bag Cap Outer July 13.stl, Base_Unit schematic.sch, Battery Case 9 - Cap.stl, Battery Case 9 - Case.stl]
2018-02-15 Created folder to store flowchart state machine diagrams of code
2018-03-18 Add BLE command parser & refactor configuration into class.
    This commit adds BLE functionality and a new command parser for use with
    the Companion App. The other major change is that instead of having a
    global configuration struct, it's been refactored into a class (with
    methods for manipulating the configuration).
    This also includes some reference docs of the commands useable over
    Serial & BLE.
    [Configuration.h]
2018-03-22 Added Eagle PCB Files for March 2018 iteration.
    [March12.sch]
2018-03-22 Moved eagle files
    Moved eagle files to new 2018 Q1 folder
    Removed unnecessary old schematic files
    [March12.sch]
2018-04-04 Replace magic number with constant for phone number length.
    [Configuration.h]
2018-04-04 added sch file
    [March22.sch]
2018-04-06 Add status update code.
    [Configuration.h]
2018-04-06 Remove PinChangeInterrupt.
    Although this library was previously the solution to our interrupt pin
    limitations, it turns out it doesn't work with SoftwareSerial (which is
    a dependency for Adafruit FONA 808):
    https://github.com/NicoHood/PinChangeInterrupt/issues/14#issuecomment-300697665
    This doesn't really matter if OPEnS Lab is moving from the Uno R3 to the
    Feather, anyways.
    [SamplerSerialEverythingV1.9OptoRTC.ino]
2018-04-13 REBASE ME: Save state before commenting out library objects.
    [Configuration.h]
2018-04-14 Store all static strings in flash memory.
    [Configuration.h]
2018-04-27 fixed broadcast manager, actually manages now Please enter the commit message for your changes. Lines starting
    [BluetoothService.java, ScheduleFragment.java]
2018-04-27 Fixed Fragment Manager
    Switched the buttons to be weighted inside a linear layout in order to
    allow for all phone screen sizes
2018-04-27 Revert "Updated button"
2018-05-04 Tweak some comments.
    [Configuration.h]
2018-05-07 Fix CommandParser bug with multiple args.
    And some cleanup.
    [CommandParser.cpp, SamplerSerialEverythingV1.9OptoRTC.ino, SerialCommandDefs.ino]
2018-05-09 NetworkStatus enum, DEBUG define, and const keywords.
    * Add a NetworkStatus enum so StatusUpdate's network state logic is
    easier to interpret
    * Add a DEBUG definition so prints for debugging don't have to be
    compiled in
    * Correct char pointers to const char pointers
    [Configuration.h]
2018-05-12 Lots of last minute cleanup! Looking good~
    [Configuration.h]
2018-06-09 Move capstone-related work into capstone folder
    [2pump_mount_3030.stl, Bag Cap Inner July 13.stl, Bag Cap July 13.f3d, Bag Cap Outer July 13.stl, Base_Unit schematic.sch, Battery Holder Bottom July 13.stl, Battery Holder July 13.f3d, Battery Holder Top July 13.stl]
2018-06-09 Removed Connection Button from Fragment Manager
    First screen seen is the scheduler, where users can connect to the
    OpenSampler device
